flynnr2/Arduino.Nano.Every.TickTock/Docs/CFG_Key_Dictionary.md

# CFG Key Dictionary

Moved to [`Protocol_Wire_Contract.md`](Protocol_Wire_Contract.md), section “CFG records and keys”.

`Protocol_Wire_Contract.md` is the primary documentation home for emitted serial records and CFG keys.
