flynnr2/Arduino.Nano.Every.TickTock/Hardware/OpticalSensorMount/preview-dual.png

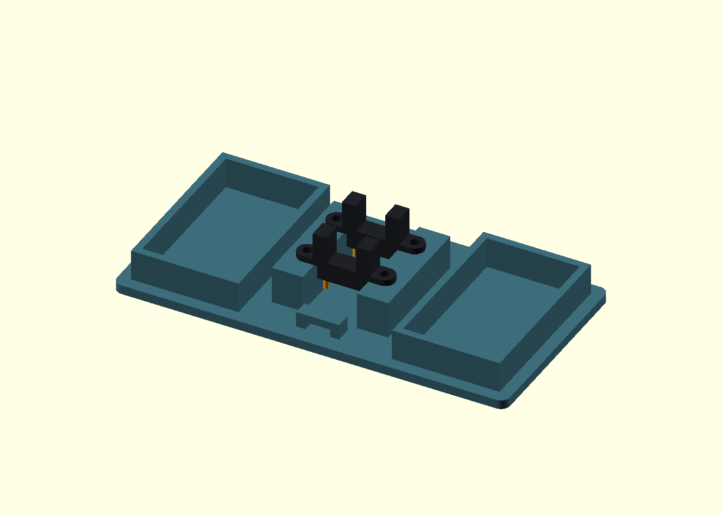
Hardware/OpticalSensorMount/preview-dual.png
