flynnr2/Arduino.Nano.Every.TickTock/Hardware/OpticalSensorMount/opb912_single.stl

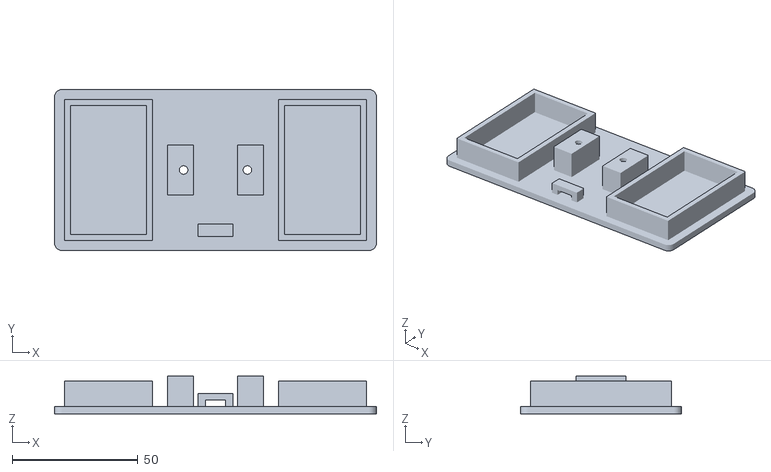
[picture p3: CAD file, 2026-11-06]
Hardware/OpticalSensorMount/opb912_single.stl
128.0 x 64.0 x 15.0
