flynnr2/Arduino.Nano.Every.TickTock/Hardware/OpticalSensorMount/opb912_fit_coupon.stl

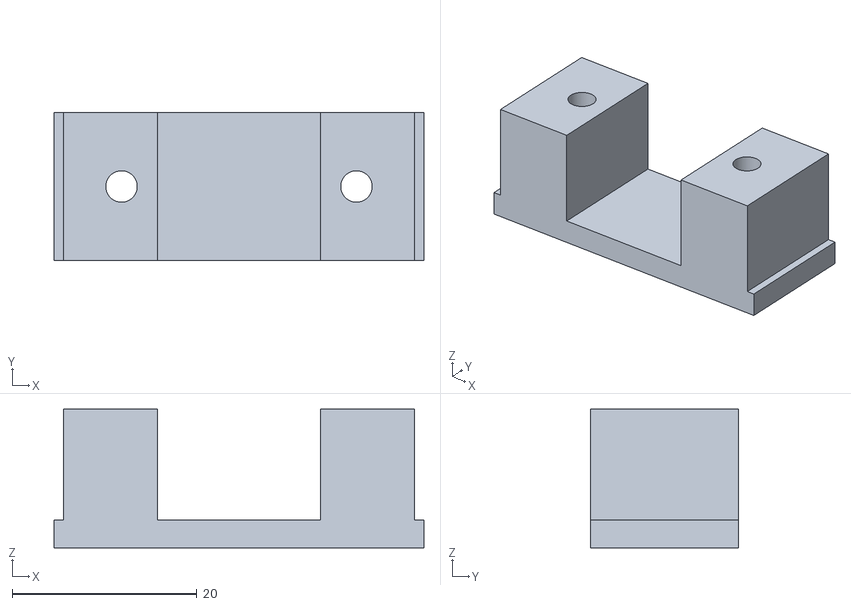
[picture p4: CAD file, 2026-11-06]
Hardware/OpticalSensorMount/opb912_fit_coupon.stl
40.0 x 16.0 x 15.0
