flynnr2/Arduino.Nano.Every.TickTock/tests/golden/phase15_impulse.csv

seq | full_s | full_resid_us | t_s
0 | 2.0 | 10.0 | 0.0
1 | 2.0 | 0.0 | 2.0
2 | 2.0 | 0.0 | 4.0
3 | 2.0 | 0.0 | 6.0
4 | 2.0 | 0.0 | 8.0
5 | 2.0 | 0.0 | 10.0
6 | 2.0 | 0.0 | 12.0
7 | 2.0 | 0.0 | 14.0
8 | 2.0 | 0.0 | 16.0
9 | 2.0 | 0.0 | 18.0
10 | 2.0 | 0.0 | 20.0
11 | 2.0 | 0.0 | 22.0
12 | 2.0 | 0.0 | 24.0
13 | 2.0 | 0.0 | 26.0
14 | 2.0 | 0.0 | 28.0
15 | 2.0 | 10.0 | 30.0
