flynnr2/Arduino.Nano.Every.TickTock/tests/golden/tick_tock_asymmetry.csv

seq | half_A_s | half_B_s | full_s | half_asymmetry_ms | full_resid_us | t_s
0 | 1.001 | 0.999 | 2.0 | 2.0 | 0.0 | 0.0
1 | 1.001 | 0.999 | 2.0 | 2.0 | 0.0 | 2.0
2 | 1.001 | 0.999 | 2.0 | 2.0 | 0.0 | 4.0
