flynnr2/Arduino.Nano.Every.TickTock/tests/raspberry_pi/fixtures/csv-reference/PCPS.CSV

seq | edge_tcb0 | gps_status | holdover_age_ms | cap16 | latency16 | now32 | drop_pps | temperature_C | humidity_pct | pressure_hPa
1 | 416000000 | 1 | 0 | 43008 | 64 | 416000064 | 0 | 20.01 | 50.00 | 1013.25
2 | 432000000 | 1 | 0 | 52224 | 64 | 432000064 | 0 | 20.02 | 50.00 | 1013.25
3 | 448000000 | 1 | 0 | 61440 | 64 | 448000064 | 0 | 20.03 | 50.00 | 1013.25
4 | 464000000 | 1 | 0 | 5120 | 64 | 464000064 | 0 | 20.04 | 50.00 | 1013.25
5 | 480000000 | 1 | 0 | 14336 | 64 | 480000064 | 0 | 20.05 | 50.00 | 1013.25
6 | 496000000 | 1 | 0 | 23552 | 64 | 496000064 | 0 | 20.06 | 50.00 | 1013.25
7 | 512000000 | 1 | 0 | 32768 | 64 | 512000064 | 0 | 20.07 | 50.00 | 1013.25
8 | 528000000 | 1 | 0 | 41984 | 64 | 528000064 | 0 | 20.08 | 50.00 | 1013.25
9 | 544000000 | 1 | 0 | 51200 | 64 | 544000064 | 0 | 20.09 | 50.00 | 1013.25
10 | 560000000 | 1 | 0 | 60416 | 64 | 560000064 | 0 | 20.10 | 50.00 | 1013.25
11 | 576000000 | 1 | 0 | 4096 | 64 | 576000064 | 0 | 20.11 | 50.00 | 1013.25
12 | 592000000 | 1 | 0 | 13312 | 64 | 592000064 | 0 | 20.12 | 50.00 | 1013.25
13 | 608000000 | 1 | 0 | 22528 | 64 | 608000064 | 0 | 20.13 | 50.00 | 1013.25
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
