flynnr2/Arduino.Nano.Every.TickTock/tests/raspberry_pi/fixtures/csv-reference/PCSW.CSV

seq | edge0_tcb0 | edge1_tcb0 | edge2_tcb0 | edge3_tcb0 | edge4_tcb0 | drop_ir | drop_pps | drop_swing | adj_diag | adj_comp_diag | temperature_C | humidity_pct | pressure_hPa
1 | 432000000 | 447600000 | 448000000 | 463600000 | 464000000 | 0 | 0 | 0 | 48 | 1755 | 20.01 | 50.00 | 1013.25
2 | 464000000 | 479600000 | 480000000 | 495600000 | 496000000 | 0 | 0 | 0 | 48 | 1755 | 20.02 | 50.00 | 1013.25
3 | 496000000 | 511600000 | 512000000 | 527600000 | 528000000 | 0 | 0 | 0 | 48 | 1755 | 20.03 | 50.00 | 1013.25
4 | 528000000 | 543600000 | 544000000 | 559600000 | 560000000 | 0 | 0 | 0 | 48 | 1755 | 20.04 | 50.00 | 1013.25
5 | 560000000 | 575600000 | 576000000 | 591600000 | 592000000 | 0 | 0 | 0 | 48 | 1755 | 20.05 | 50.00 | 1013.25
6 | 592000000 | 607600000 | 608000000 | 623600000 | 624000000 | 0 | 0 | 0 | 48 | 1755 | 20.06 | 50.00 | 1013.25
7 | 624000000 | 639600000 | 640000000 | 655600000 | 656000000 | 0 | 0 | 0 | 48 | 1755 | 20.07 | 50.00 | 1013.25
8 | 656000000 | 671600000 | 672000000 | 687600000 | 688000000 | 0 | 0 | 0 | 48 | 1755 | 20.08 | 50.00 | 1013.25
9 | 688000000 | 703600000 | 704000000 | 719600000 | 720000000 | 0 | 0 | 0 | 48 | 1755 | 20.09 | 50.00 | 1013.25
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
