flynnr2/Arduino.Nano.Every.TickTock/Hardware/NanoEveryCarrierA9/output/pdf/NanoEveryCarrier-Schematic-A9-Wired.pdf

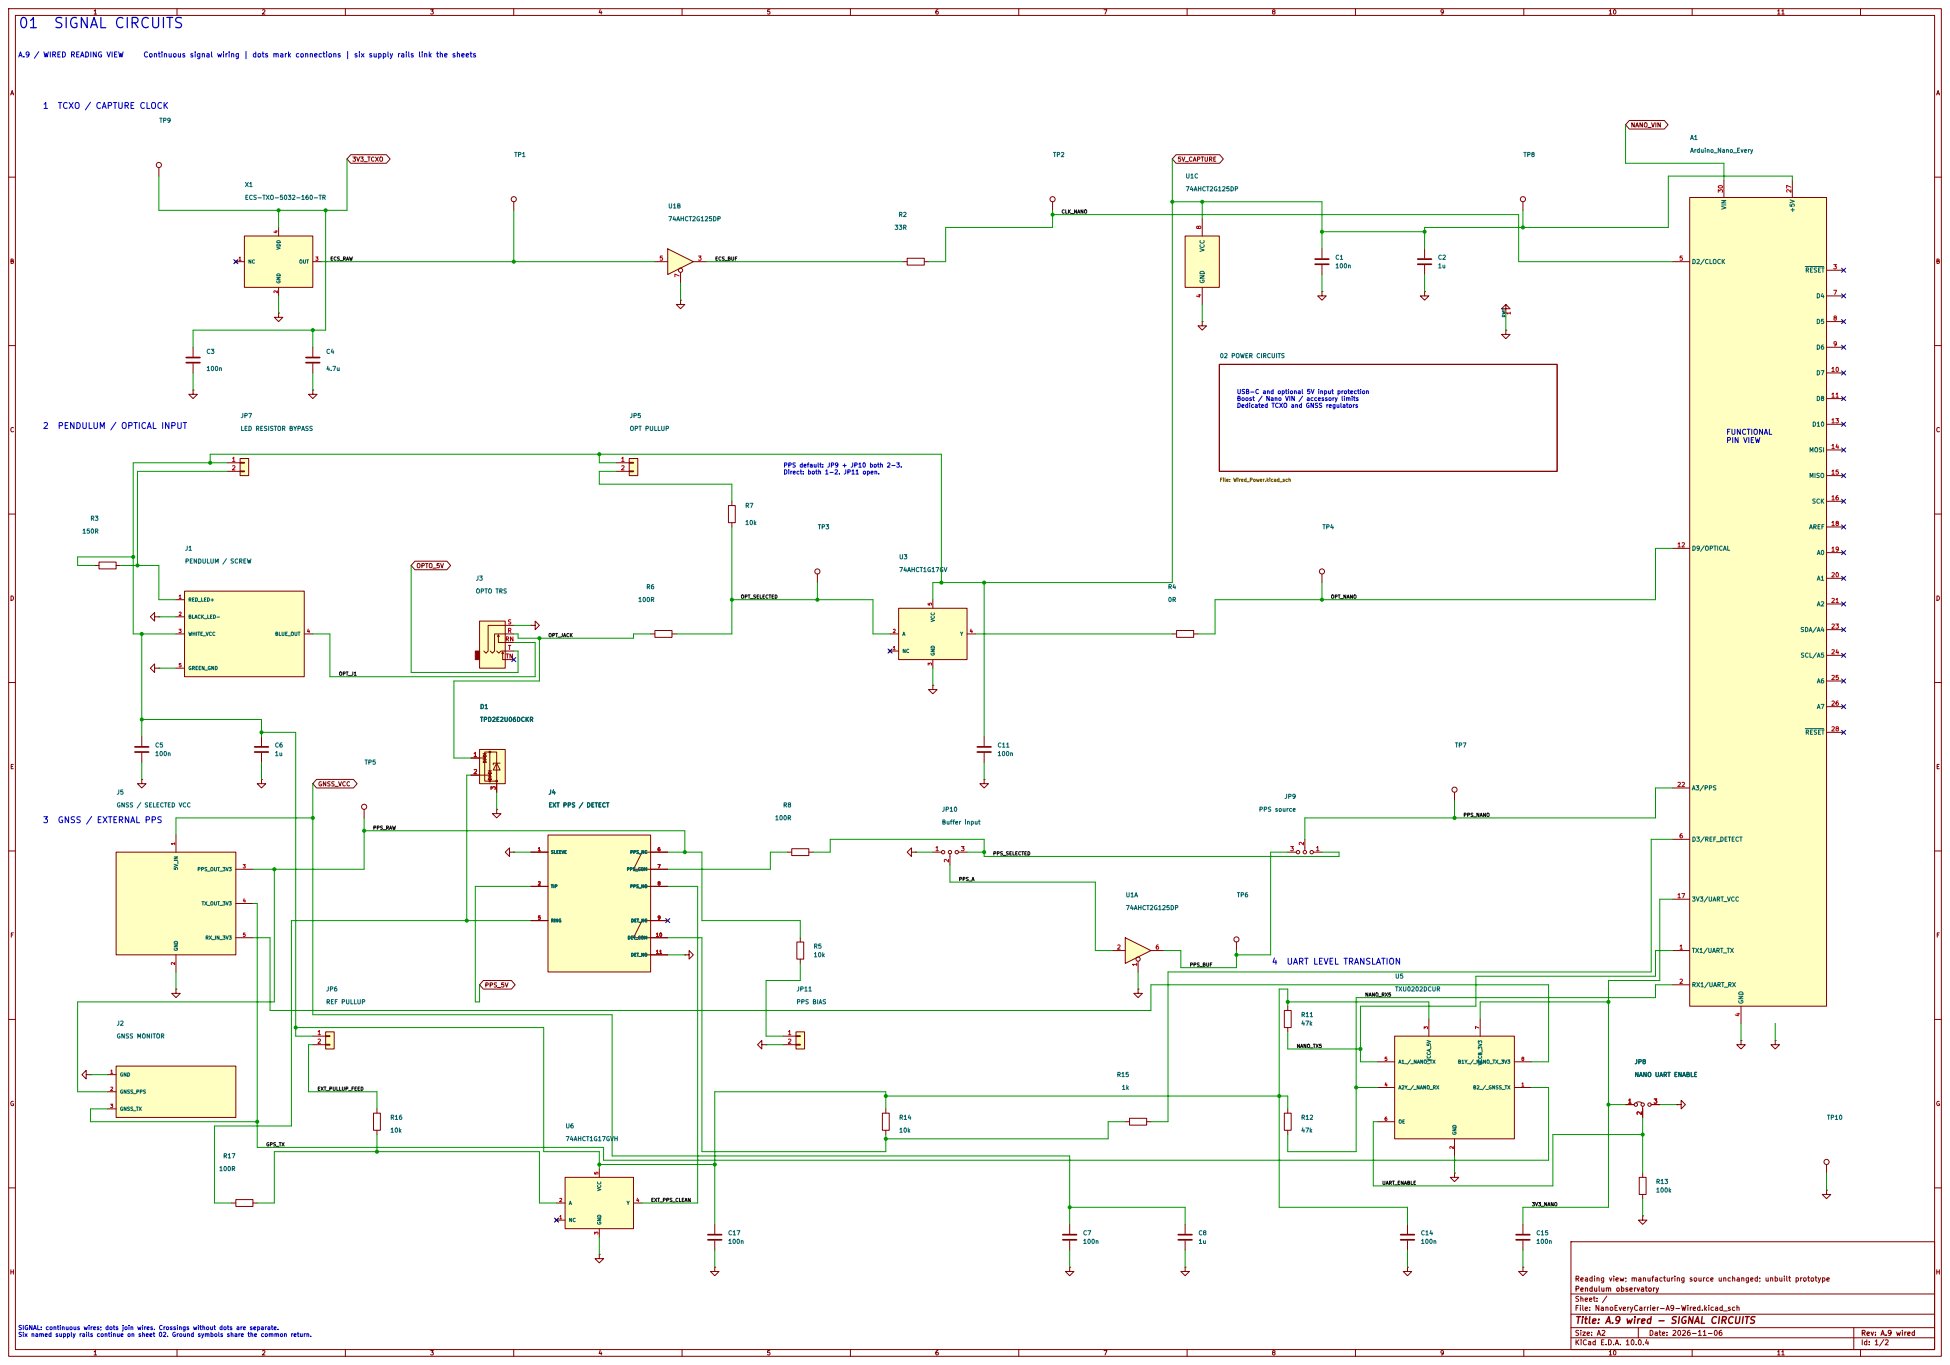
[picture p11: page 1]

USB-C and optional 5V input protection Boost / Nano VIN / accessory limits Dedicated TCXO and GNSS regulators

PPS default: JP9 + JP10 both 2-3. Direct: both 1-2. JP11 open.

Reading view; manufacturing source unchanged; unbuilt prototype
Pendulum observatory
Sheet: /
File: NanoEveryCarrier-A9-Wired.kicad_sch
Title: A.9 wired - SIGNAL CIRCUITS

SIGNAL: continuous wires; dots join wires. Crossings without dots are separate. Six named supply rails continue on sheet 02. Ground symbols share the common return.

Size: A2 | Rev: A.9 wired
KiCad E.D.A. 10.0.4 | Id: 1/2

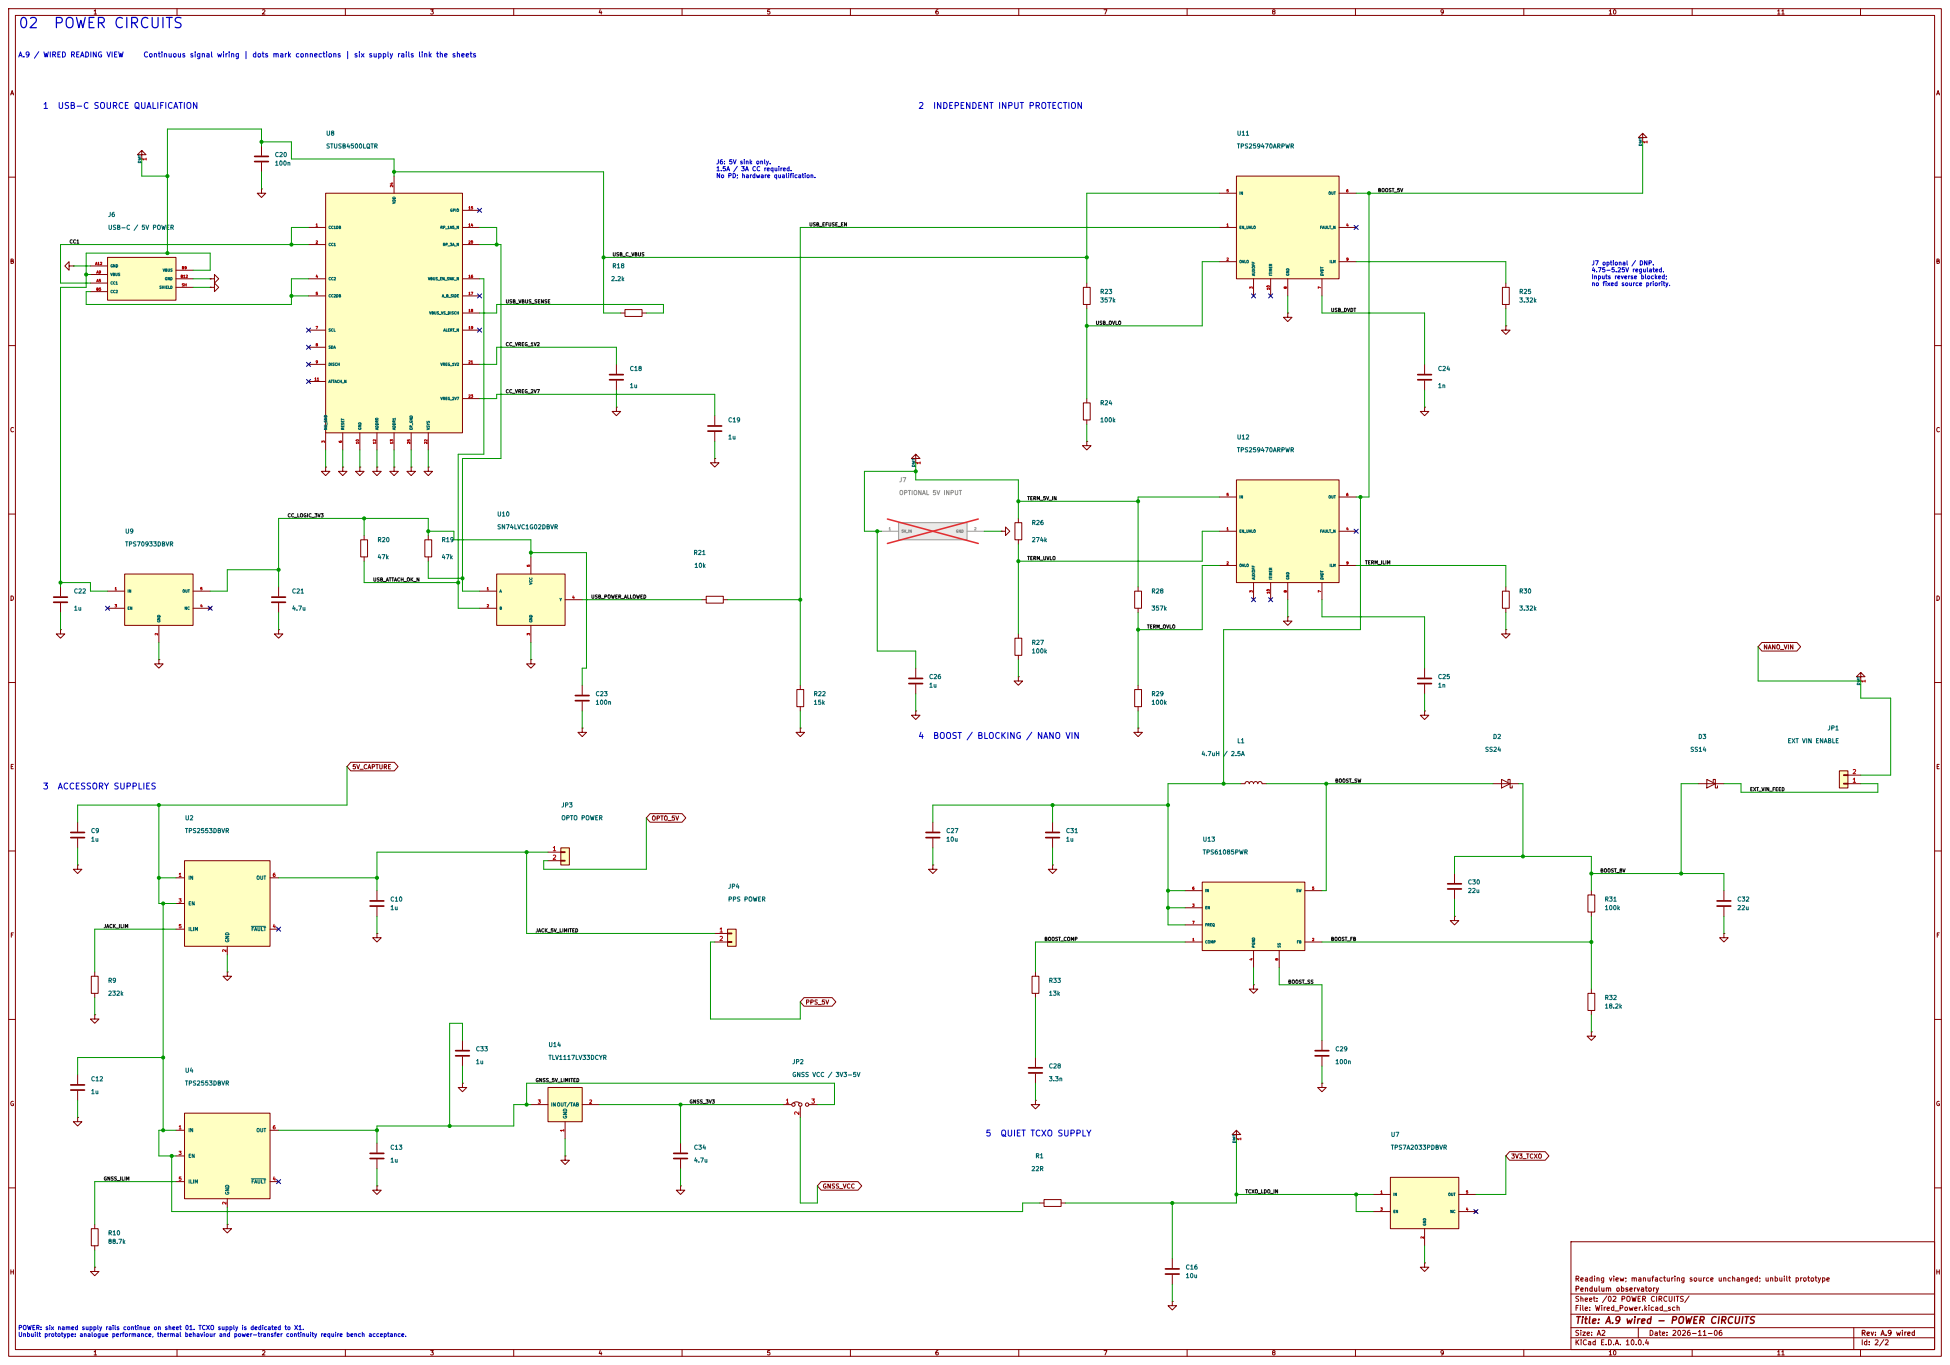
[picture p12: page 2]

J6: 5V sink only. 1.5A / 3A CC required. No PD; hardware qualification.

Inputs reverse blocked; no fixed source priority.

4 BOOST / BLOCKING / NANO VIN

Reading view; manufacturing source unchanged; unbuilt prototype
Pendulum observatory
Sheet: /02 POWER CIRCUITS/
File: Wired_Power.kicad_sch
Title: A.9 wired - POWER CIRCUITS

POWER: six named supply rails continue on sheet 01. TCXO supply is dedicated to X1. Unbuilt prototype: analogue performance, thermal behaviour and power-transfer continuity require bench acceptance.

Size: A2 | Rev: A.9 wired
KiCad E.D.A. 10.0.4 | Id: 2/2
