flynnr2/Arduino.Nano.Every.TickTock/Hardware/NanoEveryCarrierA9/NanoEveryCarrier.kicad_pcb

## KiCad design Hardware/NanoEveryCarrierA9/NanoEveryCarrier.kicad_pcb (2026-11-06)

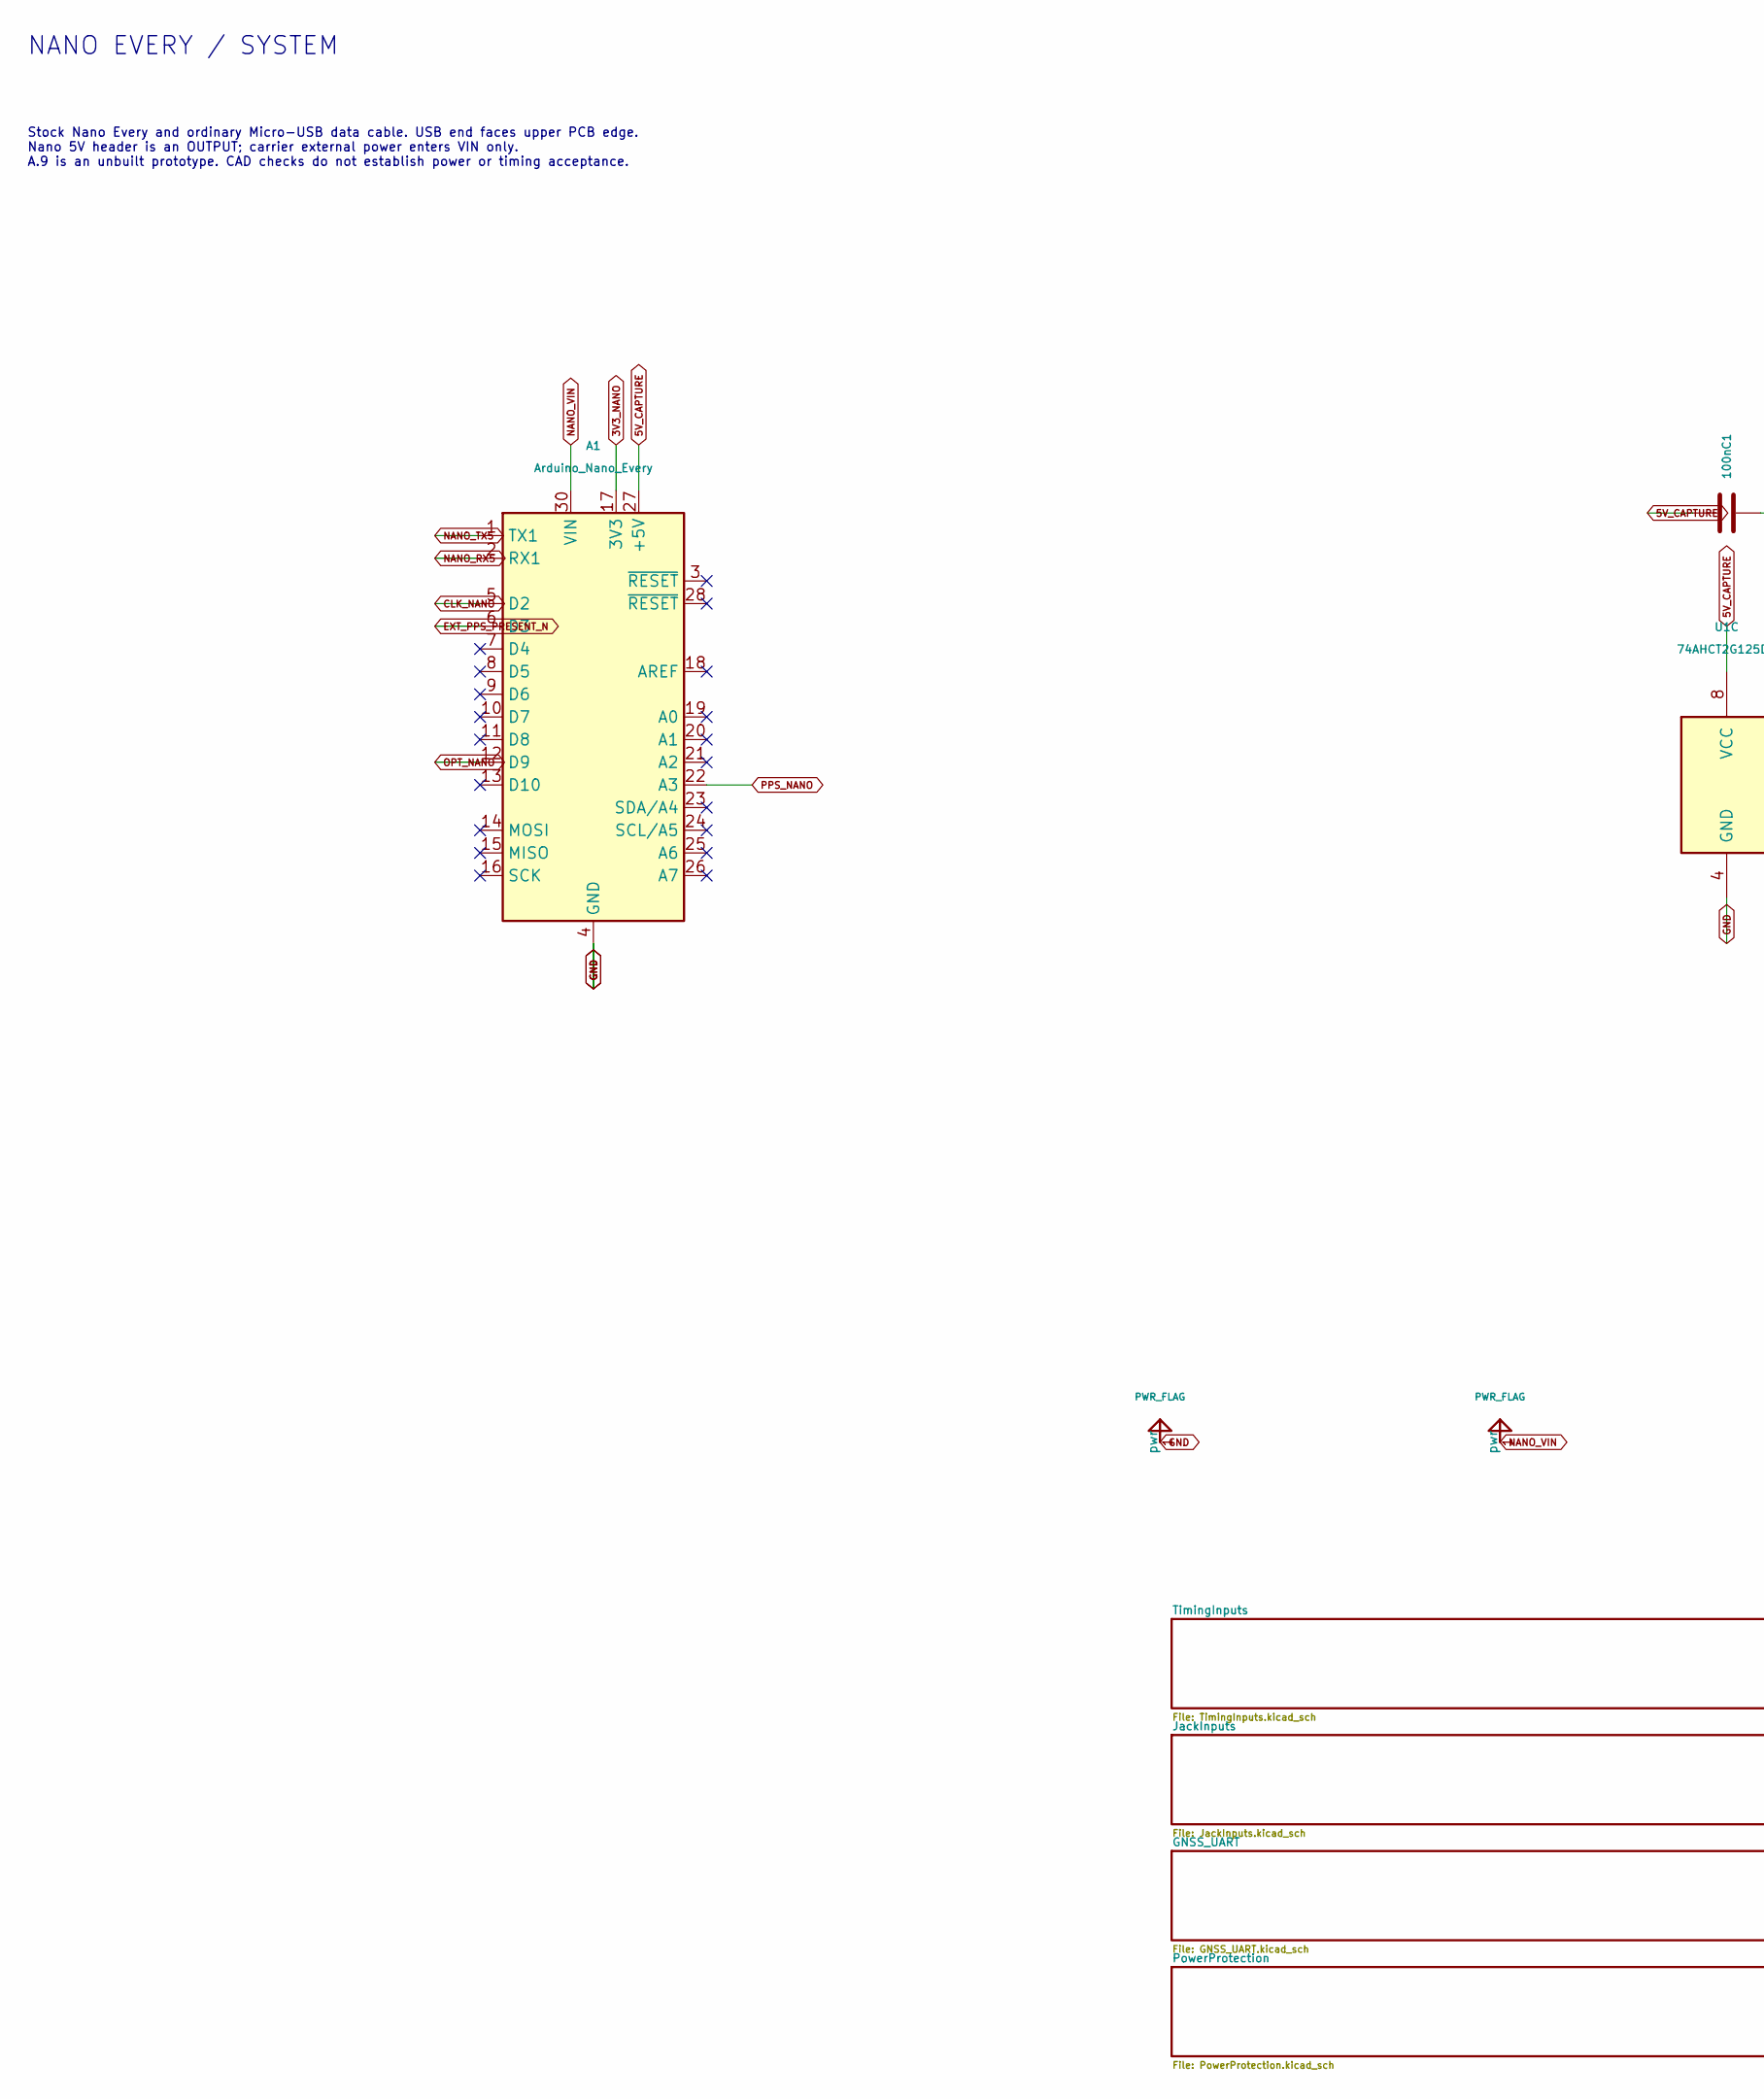
[picture p22: schematic NanoEveryCarrier.kicad_sch, A.9 | NANO EVERY / SYSTEM, part in row 1, column 1]

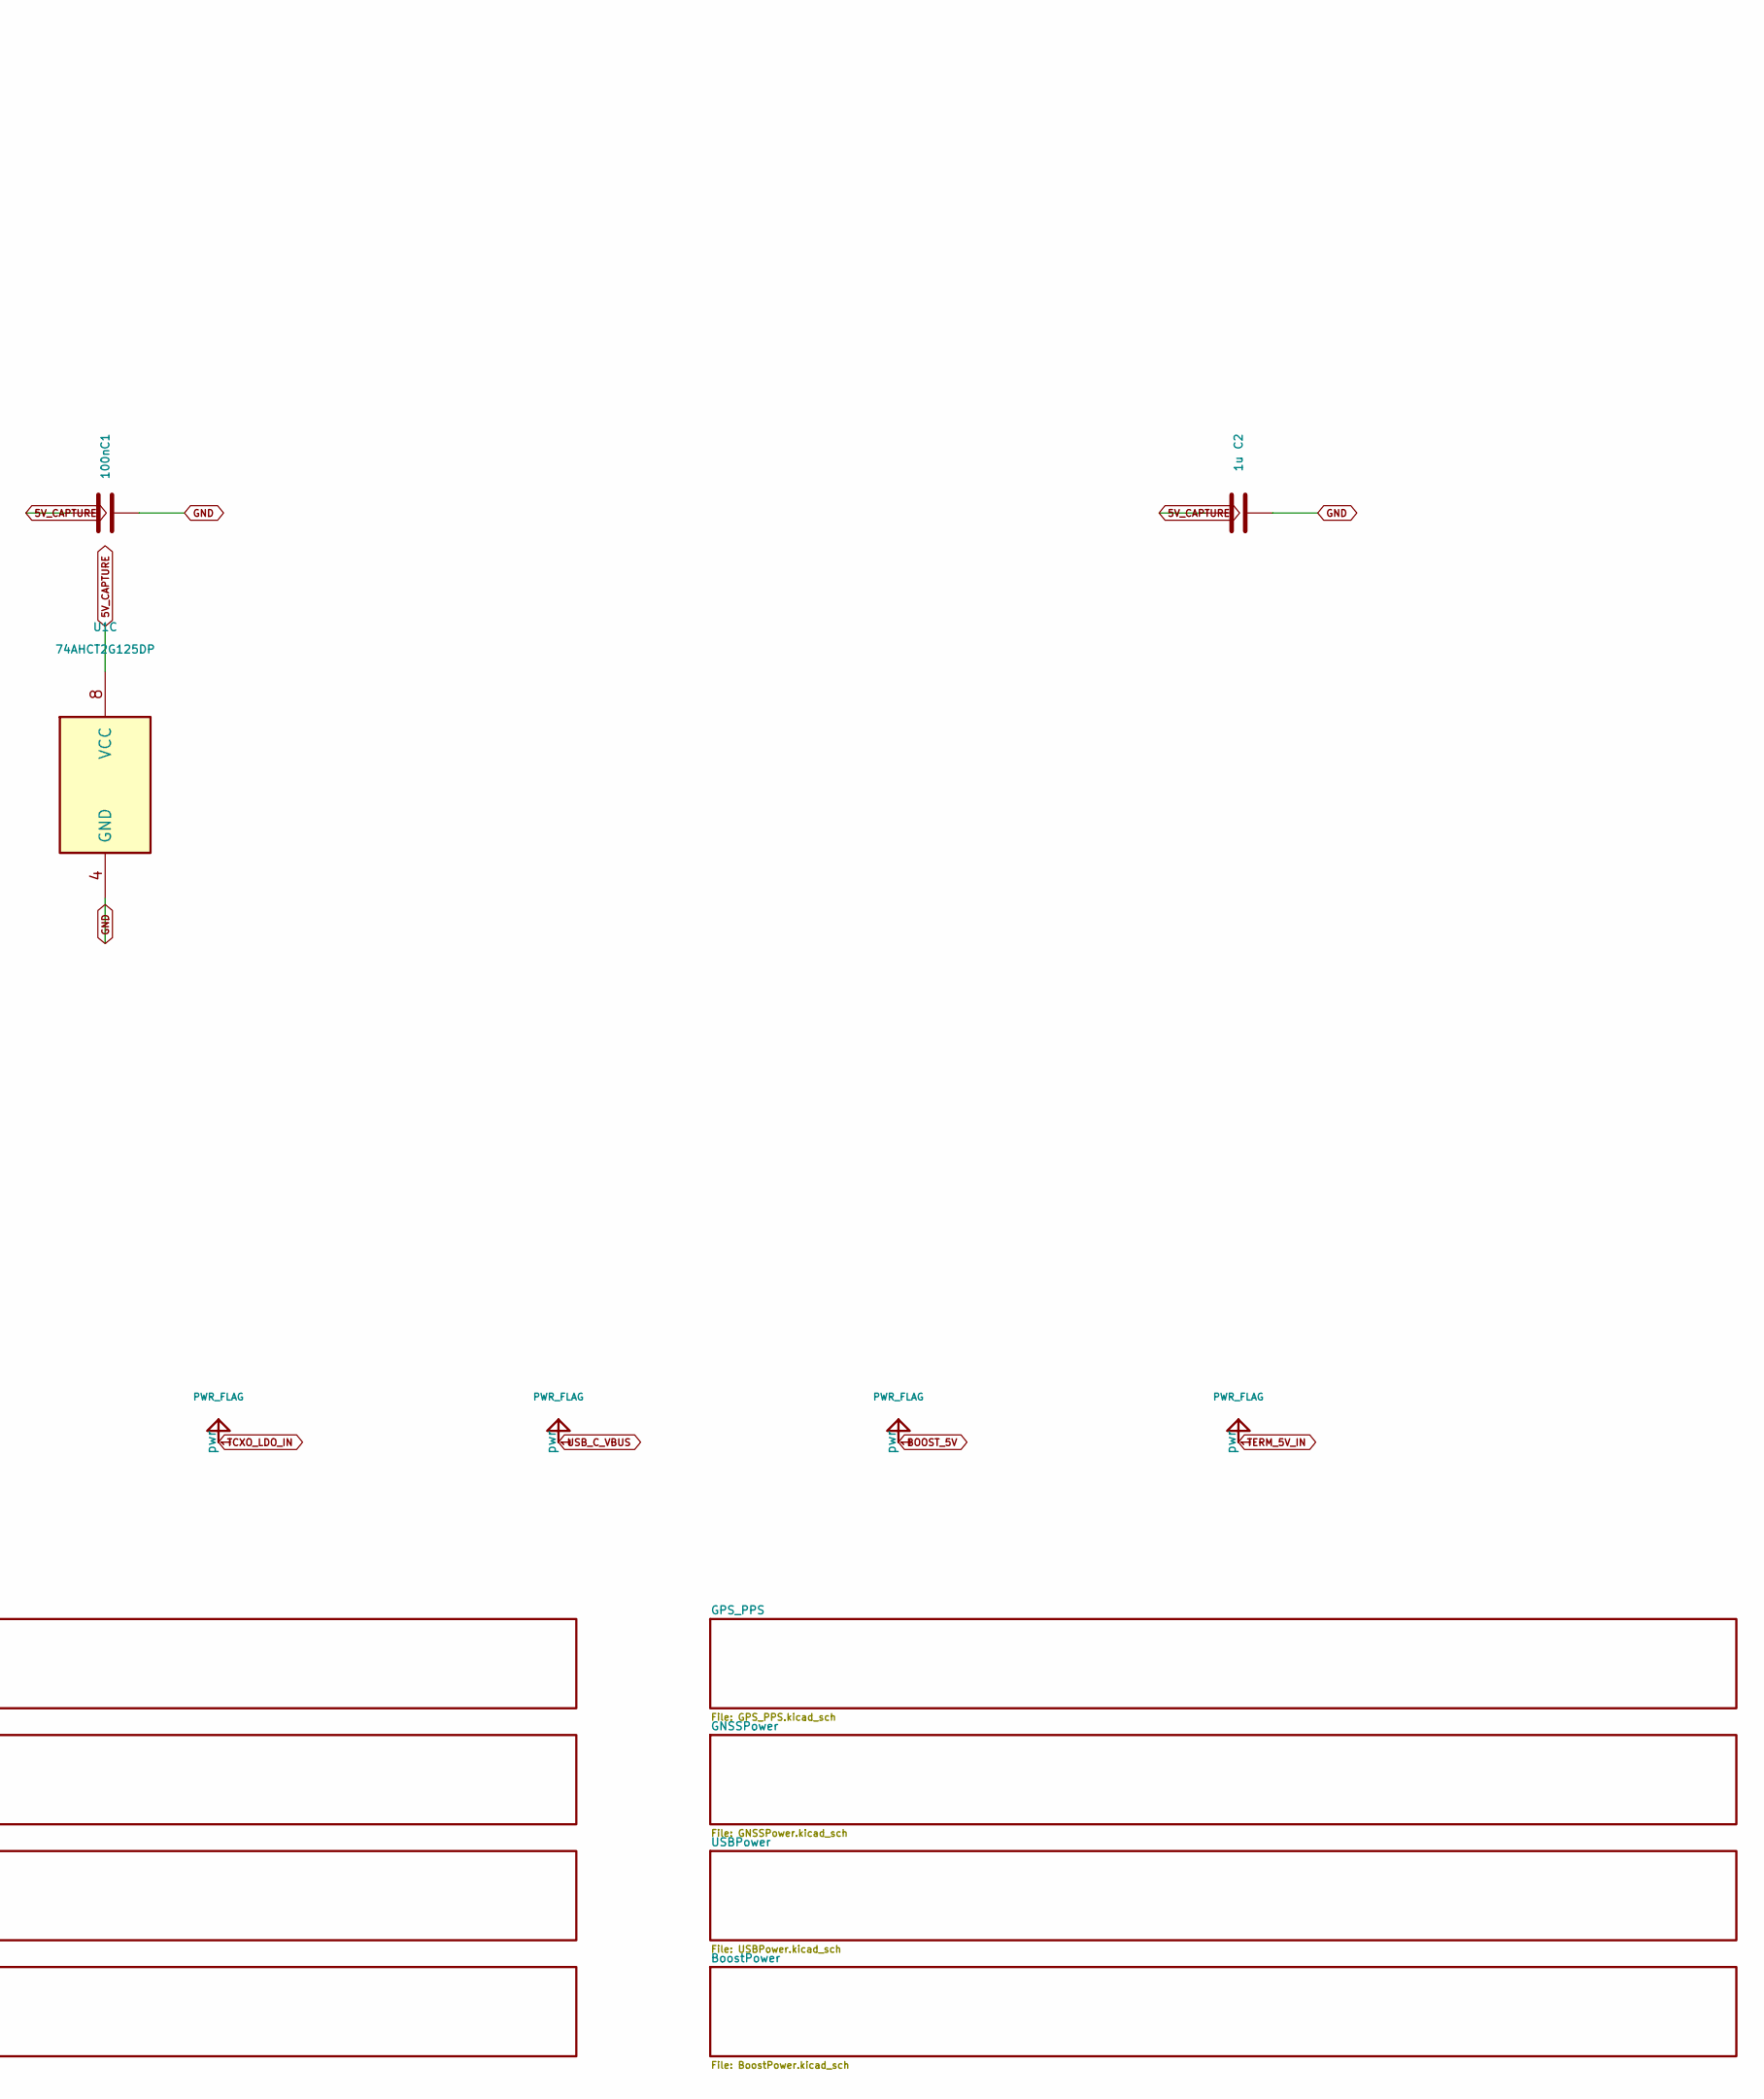
[picture p23: schematic NanoEveryCarrier.kicad_sch, A.9 | NANO EVERY / SYSTEM, part in row 1, column 2]

Parts:
A1: Arduino_Nano_Every; Nano_Every_Sockets; MPN SSW-115-01-G-S
C1: 100n; C_0805_2012Metric; MPN GRM21BR71H104KA01L
C2: 1u; C_0805_2012Metric; MPN GRM21BR71C105KA01L
U1: 74AHCT2G125DP; TSSOP-8_3x3mm_P0.65mm; MPN 74AHCT2G125DP,125

Connections:
3V3_NANO: A1.17 (3V3); also elsewhere on the board
5V_CAPTURE: A1.27 (+5V), C1.1, C2.1, U1.8 (VCC); also elsewhere on the board
CLK_NANO: A1.5 (D2); also elsewhere on the board
EXT_PPS_PRESENT_N: A1.6 (D3); also elsewhere on the board
GND: A1.4 (GND), A1.29 (GND), C1.2, C2.2, U1.4 (GND); also elsewhere on the board
NANO_RX5: A1.2 (RX1); also elsewhere on the board
NANO_TX5: A1.1 (TX1); also elsewhere on the board
NANO_VIN: A1.30 (VIN); also elsewhere on the board
OPT_NANO: A1.12 (D9); also elsewhere on the board
PPS_NANO: A1.22 (A3); also elsewhere on the board

Notes on the sheet:
NANO EVERY / SYSTEM
Stock Nano Every and ordinary Micro-USB data cable. USB end faces upper PCB edge. Nano 5V header is an OUTPUT; carrier external power enters VIN only. A.9 is an unbuilt prototype. CAD checks do not establish power or timing acceptance.

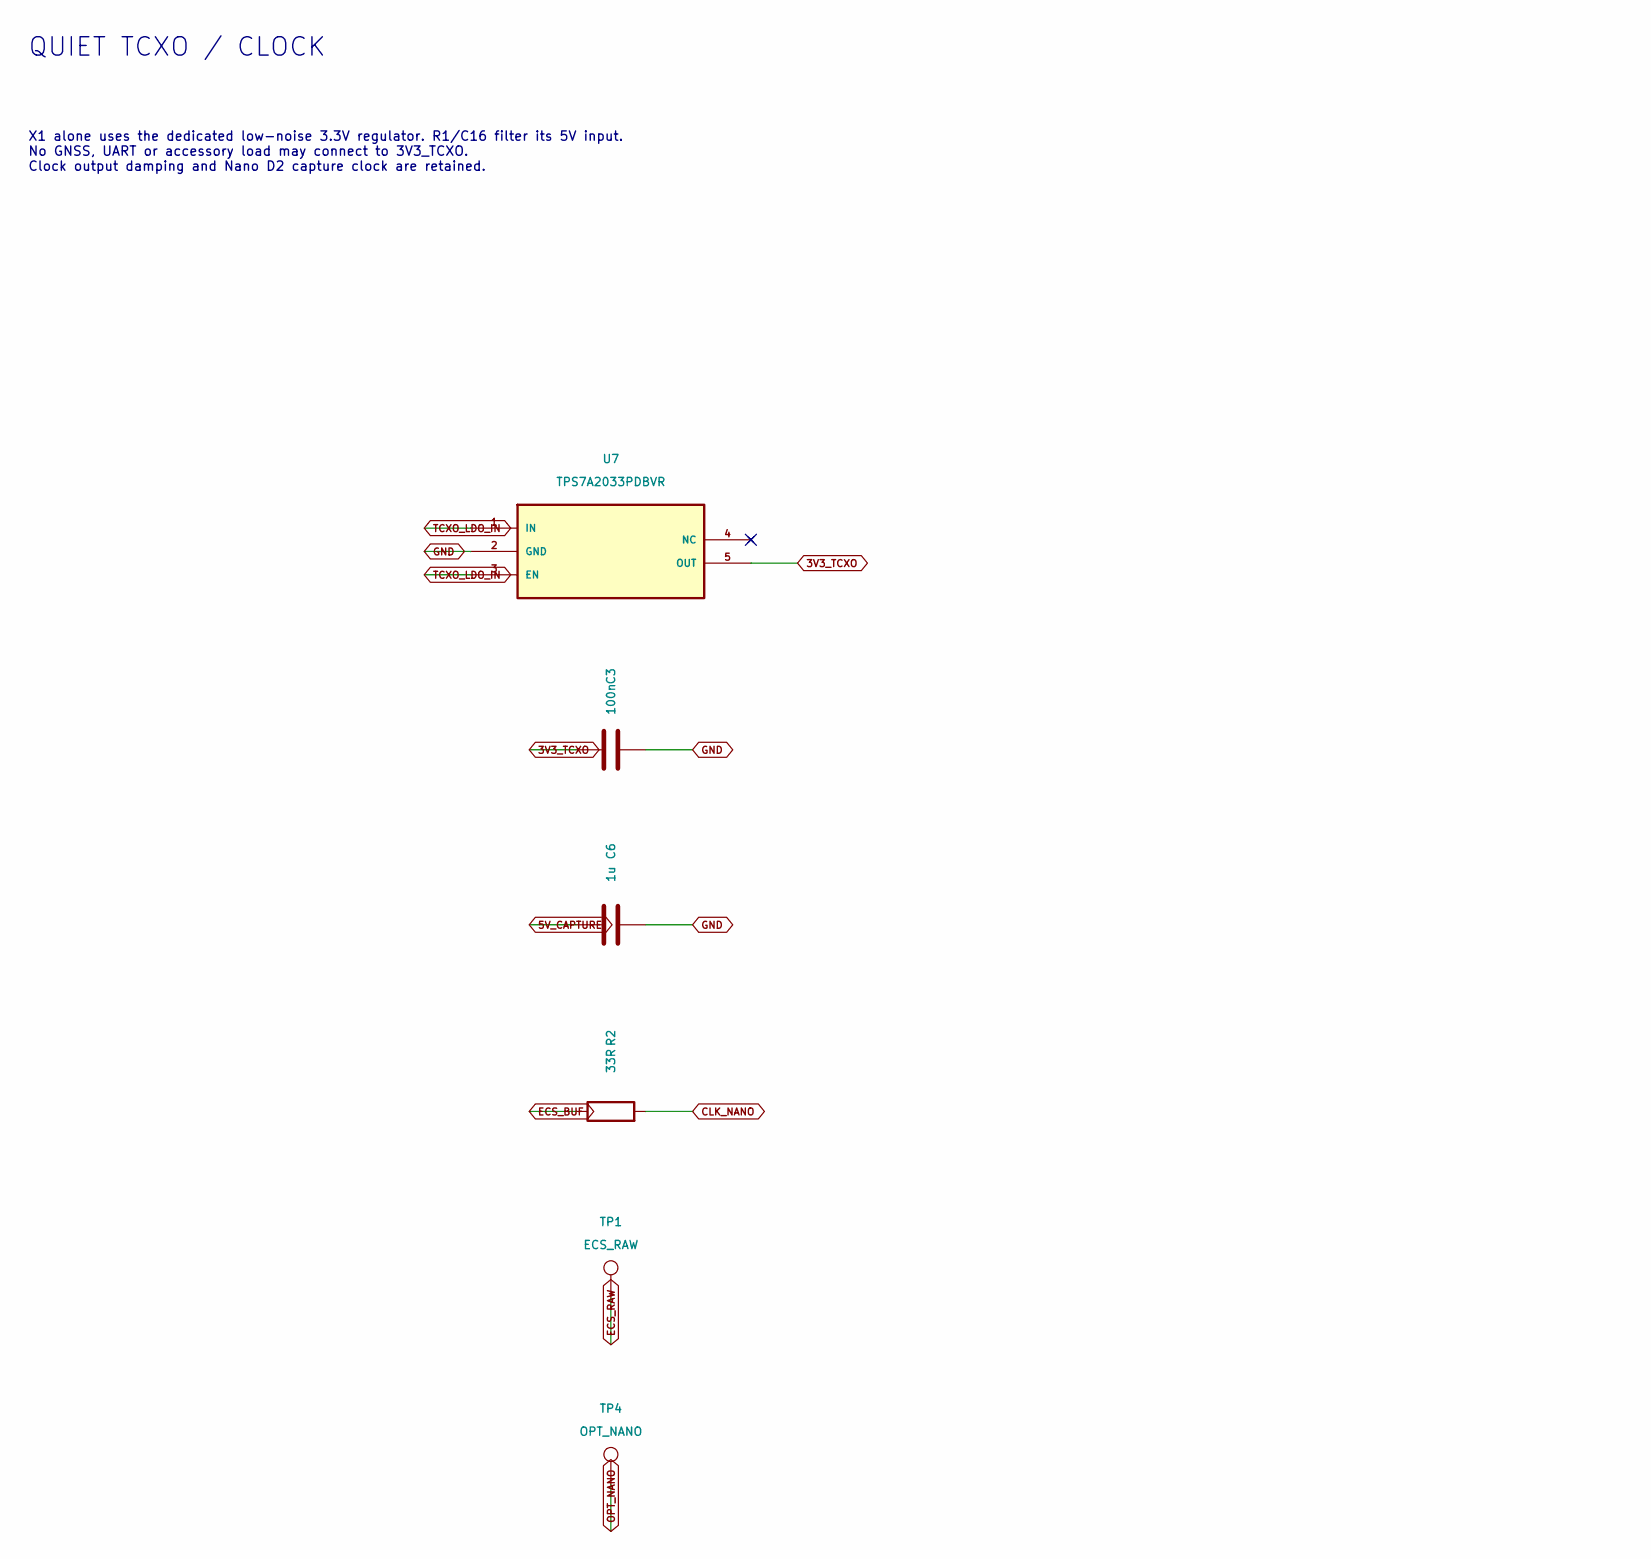
[picture p24: schematic TimingInputs.kicad_sch, A.9 | QUIET TCXO / CLOCK, part in row 1, column 1]

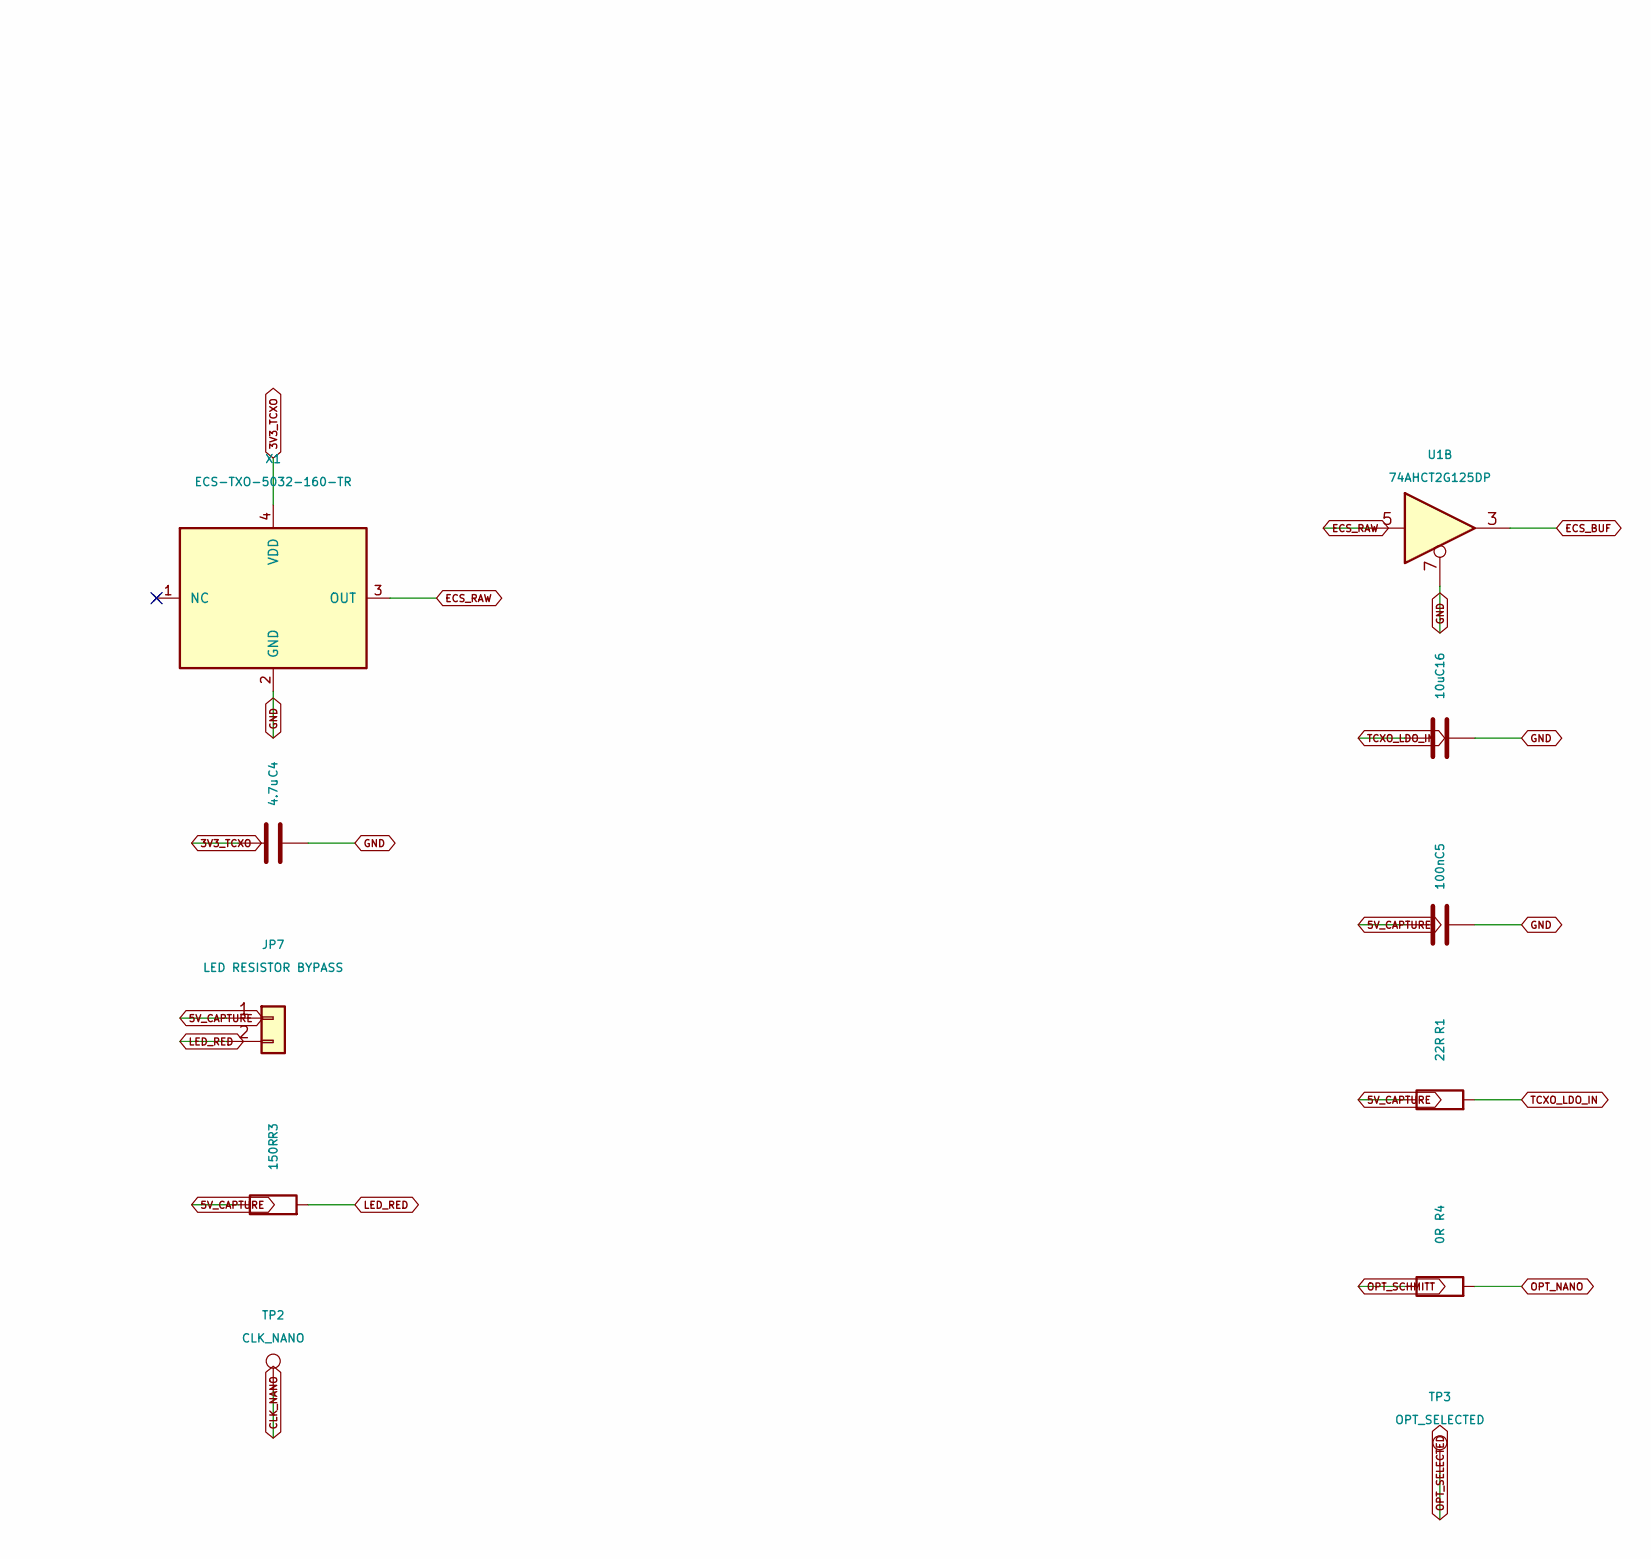
[picture p25: schematic TimingInputs.kicad_sch, A.9 | QUIET TCXO / CLOCK, part in row 1, column 2]

Parts:
C3, C5: 100n; C_0805_2012Metric; MPN GRM21BR71H104KA01L
C4: 4.7u; C_0805_2012Metric; MPN GRM21BR71C475KA73L
C6: 1u; C_0805_2012Metric; MPN GRM21BR71C105KA01L
C16: 10u; C_0805_2012Metric; MPN GRM21BR61C106KE15L
JP7: LED RESISTOR BYPASS; PinHeader_1x02_P2.54mm_Vertical; MPN TSW-102-07-G-S
R1: 22R; R_0805_2012Metric; MPN RC0805FR-0722RL
R2: 33R; R_1206_3216Metric_Pad1.30x1.75mm_HandSolder; MPN RC1206FR-0733RL
R3: 150R; R_1206_3216Metric; MPN RC1206FR-07150RL
R4: 0R; R_1206_3216Metric_Pad1.30x1.75mm_HandSolder; MPN RC1206JR-070RL
TP1: ECS_RAW; TestPoint_Pad_D1.0mm
TP2: CLK_NANO; TestPoint_Pad_D1.0mm
TP3: OPT_SELECTED; TestPoint_Pad_D1.0mm
TP4: OPT_NANO; TestPoint_Pad_D1.0mm
U1: 74AHCT2G125DP; TSSOP-8_3x3mm_P0.65mm; MPN 74AHCT2G125DP,125
U7: TPS7A2033PDBVR; SOT-23-5; MPN TPS7A2033PDBVR
X1: ECS-TXO-5032-160-TR; ECS_TXO_5032; MPN ECS-TXO-5032-160-TR

Connections:
3V3_TCXO: C3.1, C4.1, U7.5 (OUT), X1.4 (VDD); also elsewhere on the board
5V_CAPTURE: C5.1, C6.1, JP7.1, R1.1, R3.1; also elsewhere on the board
CLK_NANO: R2.2, TP2.1; also elsewhere on the board
ECS_BUF: R2.1, U1.3
ECS_RAW: TP1.1, U1.5, X1.3 (OUT)
GND: C3.2, C4.2, C5.2, C6.2, C16.2, U1.7, U7.2 (GND), X1.2 (GND); also elsewhere on the board
LED_RED: JP7.2, R3.2; also elsewhere on the board
OPT_NANO: R4.2, TP4.1; also elsewhere on the board
OPT_SCHMITT: R4.1; also elsewhere on the board
OPT_SELECTED: TP3.1; also elsewhere on the board
TCXO_LDO_IN: C16.1, R1.2, U7.1 (IN), U7.3 (EN)

Notes on the sheet:
QUIET TCXO / CLOCK
X1 alone uses the dedicated low-noise 3.3V regulator. R1/C16 filter its 5V input. No GNSS, UART or accessory load may connect to 3V3_TCXO. Clock output damping and Nano D2 capture clock are retained.

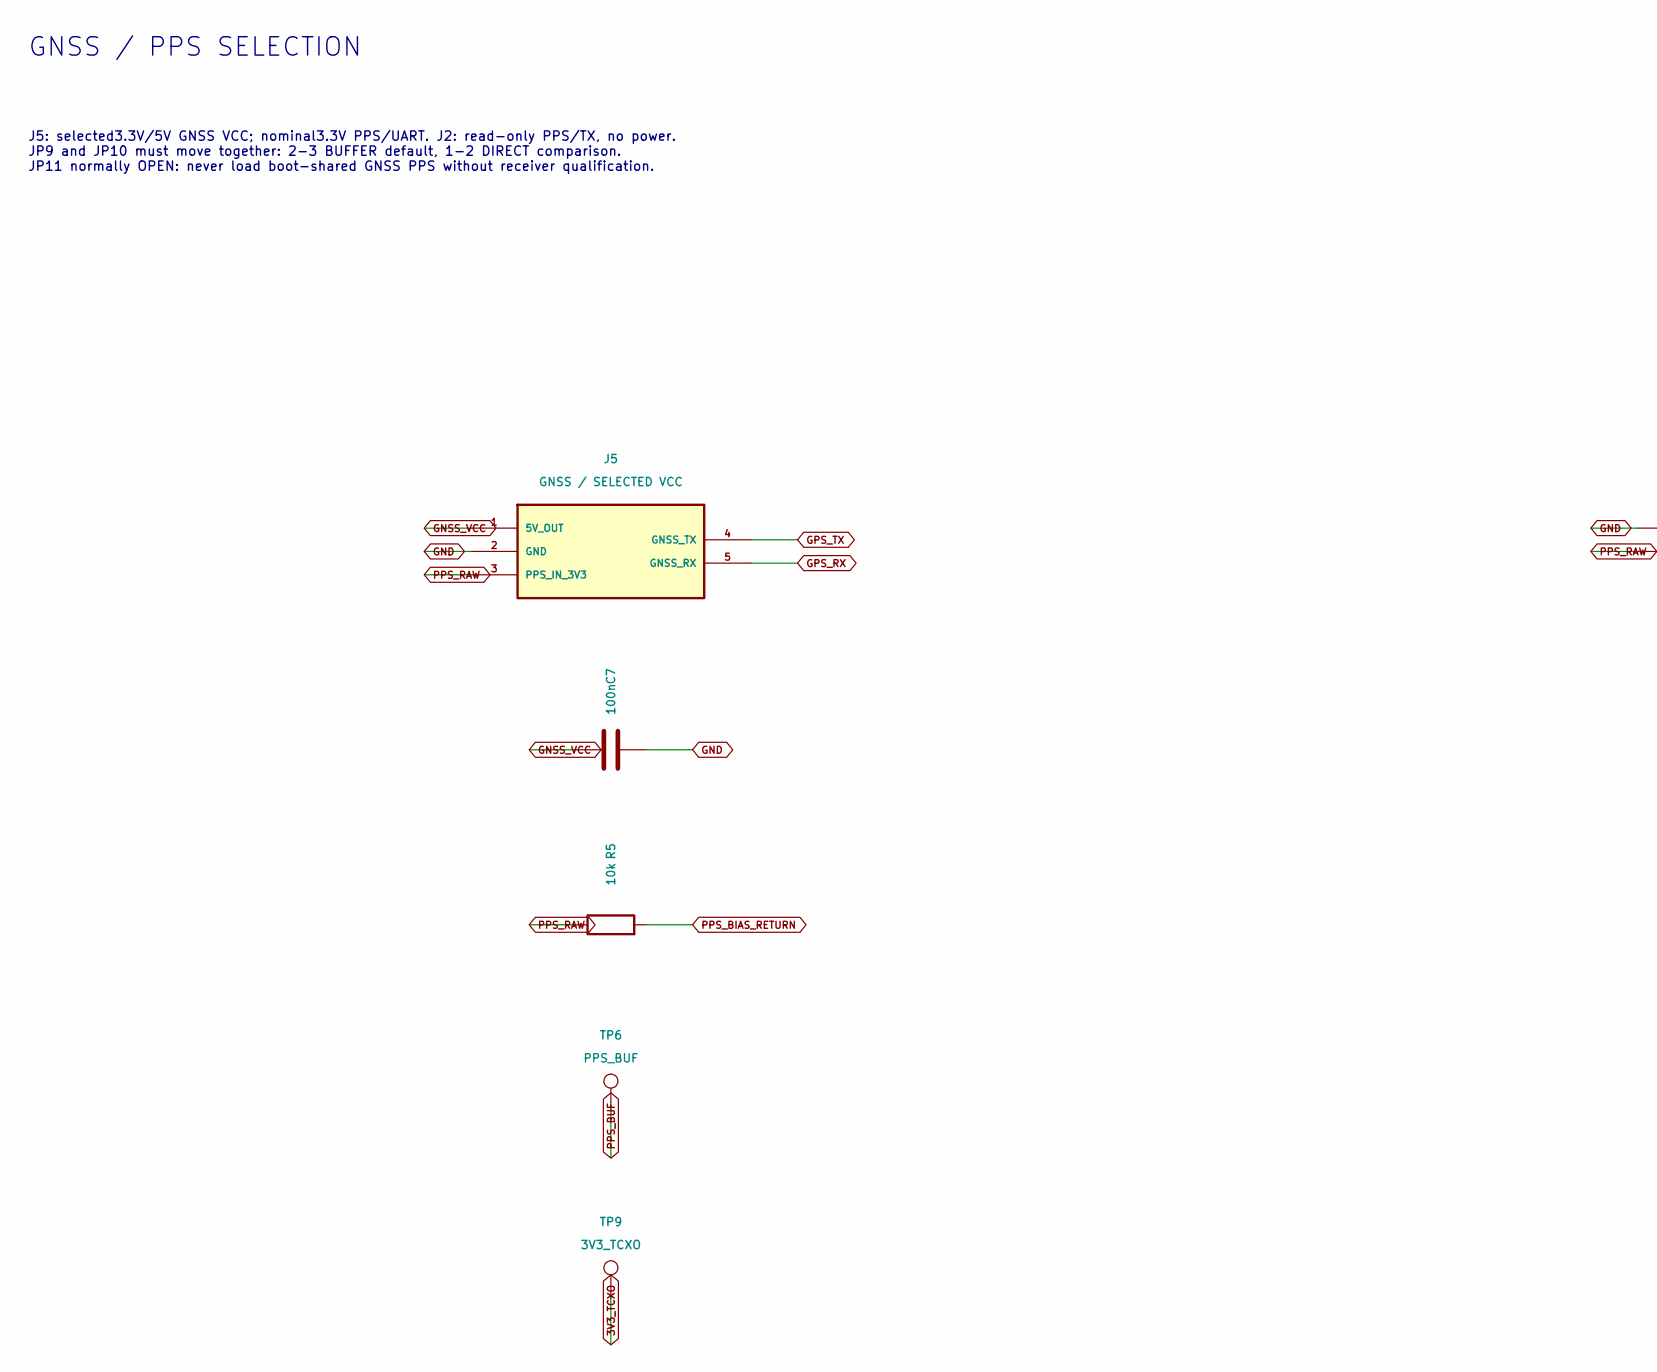
[picture p26: schematic GPS_PPS.kicad_sch, A.9 | GNSS / PPS SELECTION, part in row 1, column 1]

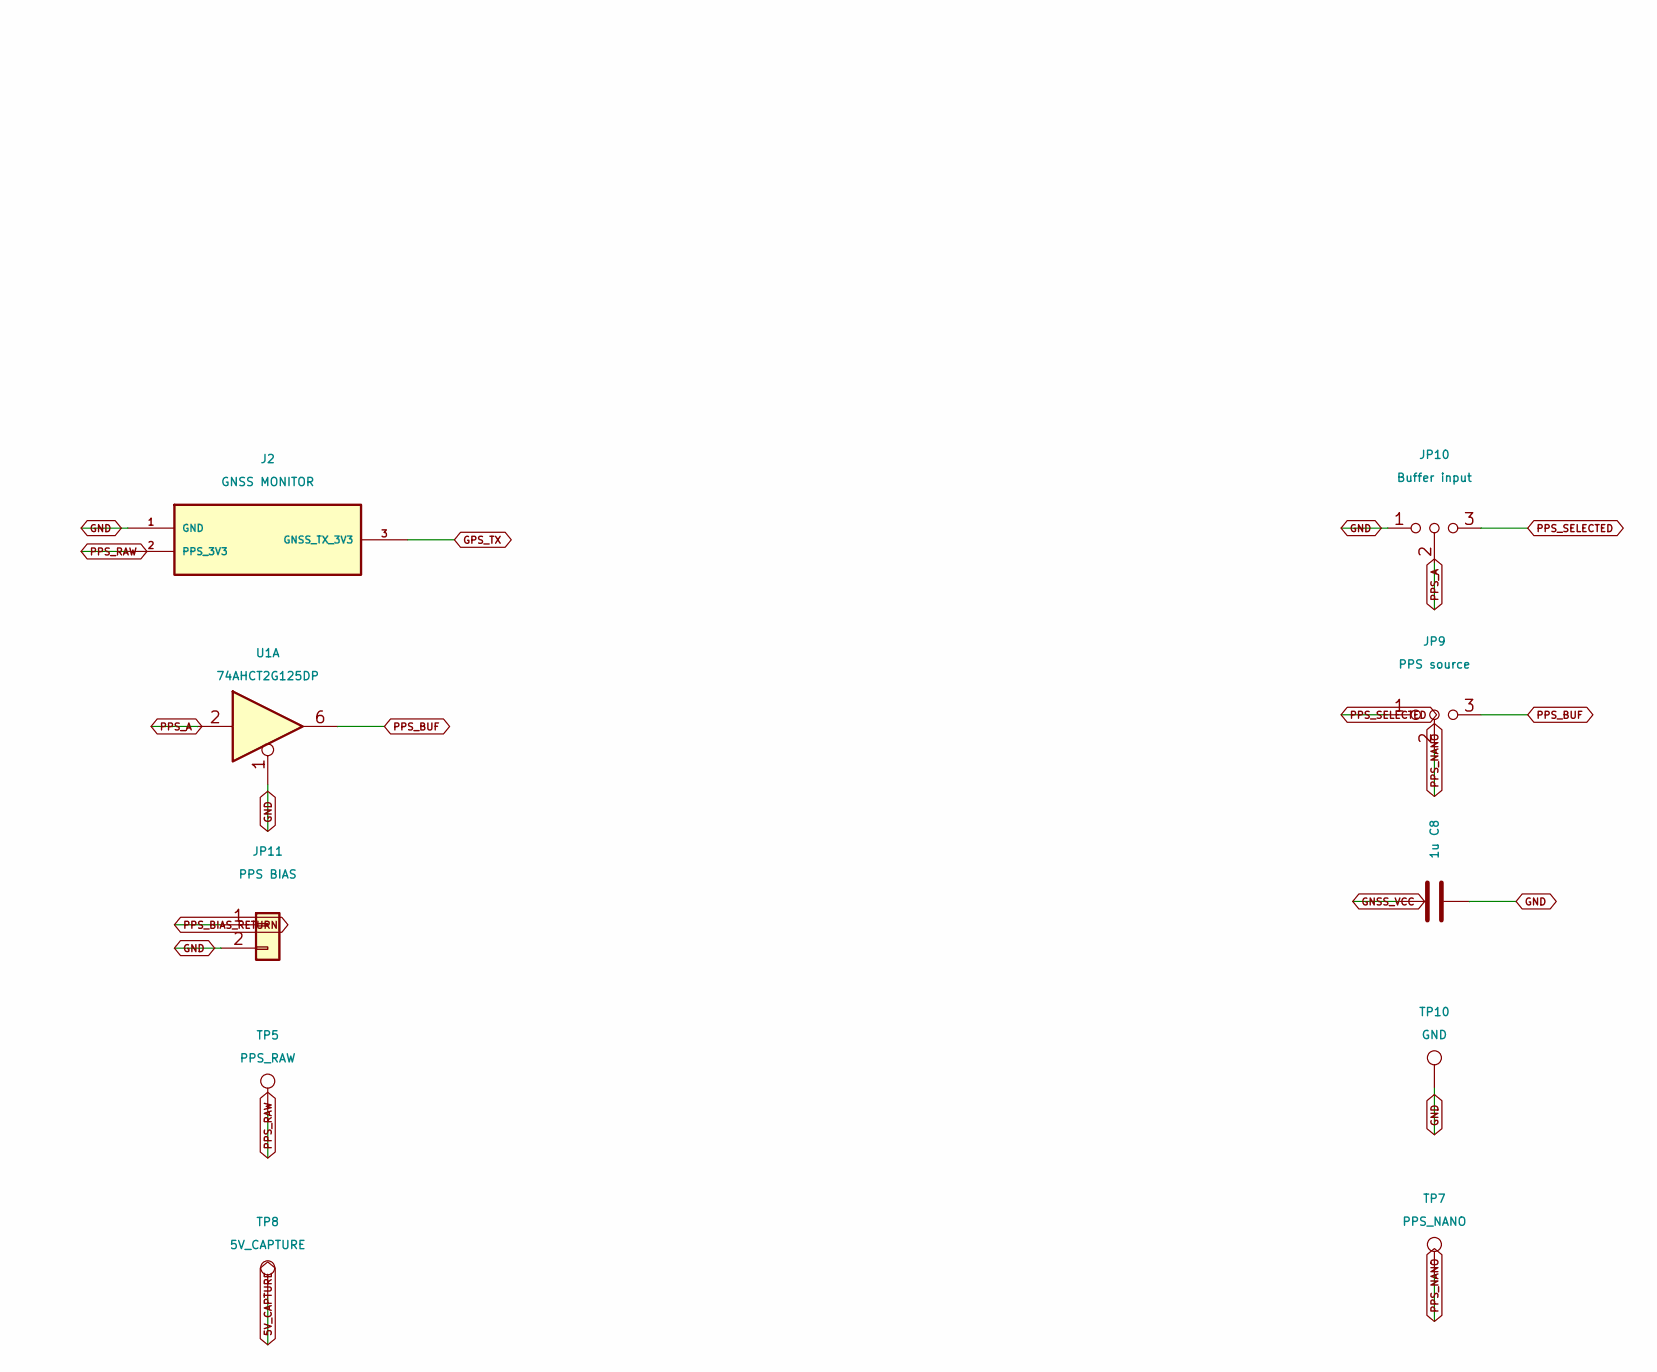
[picture p27: schematic GPS_PPS.kicad_sch, A.9 | GNSS / PPS SELECTION, part in row 1, column 2]

Parts:
C7: 100n; C_0805_2012Metric; MPN GRM21BR71H104KA01L
C8: 1u; C_0805_2012Metric; MPN GRM21BR71C105KA01L
J2: GNSS MONITOR; PinHeader_1x03_P2.54mm_Vertical; MPN TSW-103-07-G-S
J5: GNSS / SELECTED VCC; PinHeader_1x05_P2.54mm_Vertical; MPN TSW-105-07-G-S
JP9: PPS source; PinHeader_1x03_P2.54mm_Vertical; MPN TSW-103-07-G-S
JP10: Buffer input; PinHeader_1x03_P2.54mm_Vertical; MPN TSW-103-07-G-S
JP11: PPS BIAS; PinHeader_1x02_P2.54mm_Vertical; MPN TSW-102-07-G-S
R5: 10k; R_0805_2012Metric; MPN RC0805FR-0710KL
TP5: PPS_RAW; TestPoint_Pad_D1.0mm
TP6: PPS_BUF; TestPoint_Pad_D1.0mm
TP7: PPS_NANO; TestPoint_Pad_D1.0mm
TP8: 5V_CAPTURE; TestPoint_Pad_D1.0mm
TP9: 3V3_TCXO; TestPoint_Pad_D1.0mm
TP10: GND; TestPoint_Pad_D1.0mm
U1: 74AHCT2G125DP; TSSOP-8_3x3mm_P0.65mm; MPN 74AHCT2G125DP,125

Connections:
3V3_TCXO: TP9.1; also elsewhere on the board
5V_CAPTURE: TP8.1; also elsewhere on the board
GND: C7.2, C8.2, J2.1 (GND), J5.2 (GND), JP10.1 (A), JP11.2, TP10.1, U1.1; also elsewhere on the board
GNSS_VCC: C7.1, C8.1, J5.1 (5V_OUT); also elsewhere on the board
GPS_RX: J5.5 (GNSS_RX); also elsewhere on the board
GPS_TX: J2.3 (GNSS_TX_3V3), J5.4 (GNSS_TX); also elsewhere on the board
PPS_A: JP10.2 (C), U1.2
PPS_BIAS_RETURN: JP11.1, R5.2
PPS_BUF: JP9.3 (B), TP6.1, U1.6
PPS_NANO: JP9.2 (C), TP7.1; also elsewhere on the board
PPS_RAW: J2.2 (PPS_3V3), J5.3 (PPS_IN_3V3), R5.1, TP5.1; also elsewhere on the board
PPS_SELECTED: JP9.1 (A), JP10.3 (B); also elsewhere on the board

Notes on the sheet:
GNSS / PPS SELECTION
J5: selected3.3V/5V GNSS VCC; nominal3.3V PPS/UART. J2: read-only PPS/TX, no power. JP9 and JP10 must move together: 2-3 BUFFER default, 1-2 DIRECT comparison. JP11 normally OPEN: never load boot-shared GNSS PPS without receiver qualification.
