flynnr2/Arduino.Nano.Every.TickTock/Hardware/NanoEveryCarrierA9/NanoEveryCarrier.kicad_pcb

## KiCad design Hardware/NanoEveryCarrierA9/NanoEveryCarrier.kicad_pcb (continued)

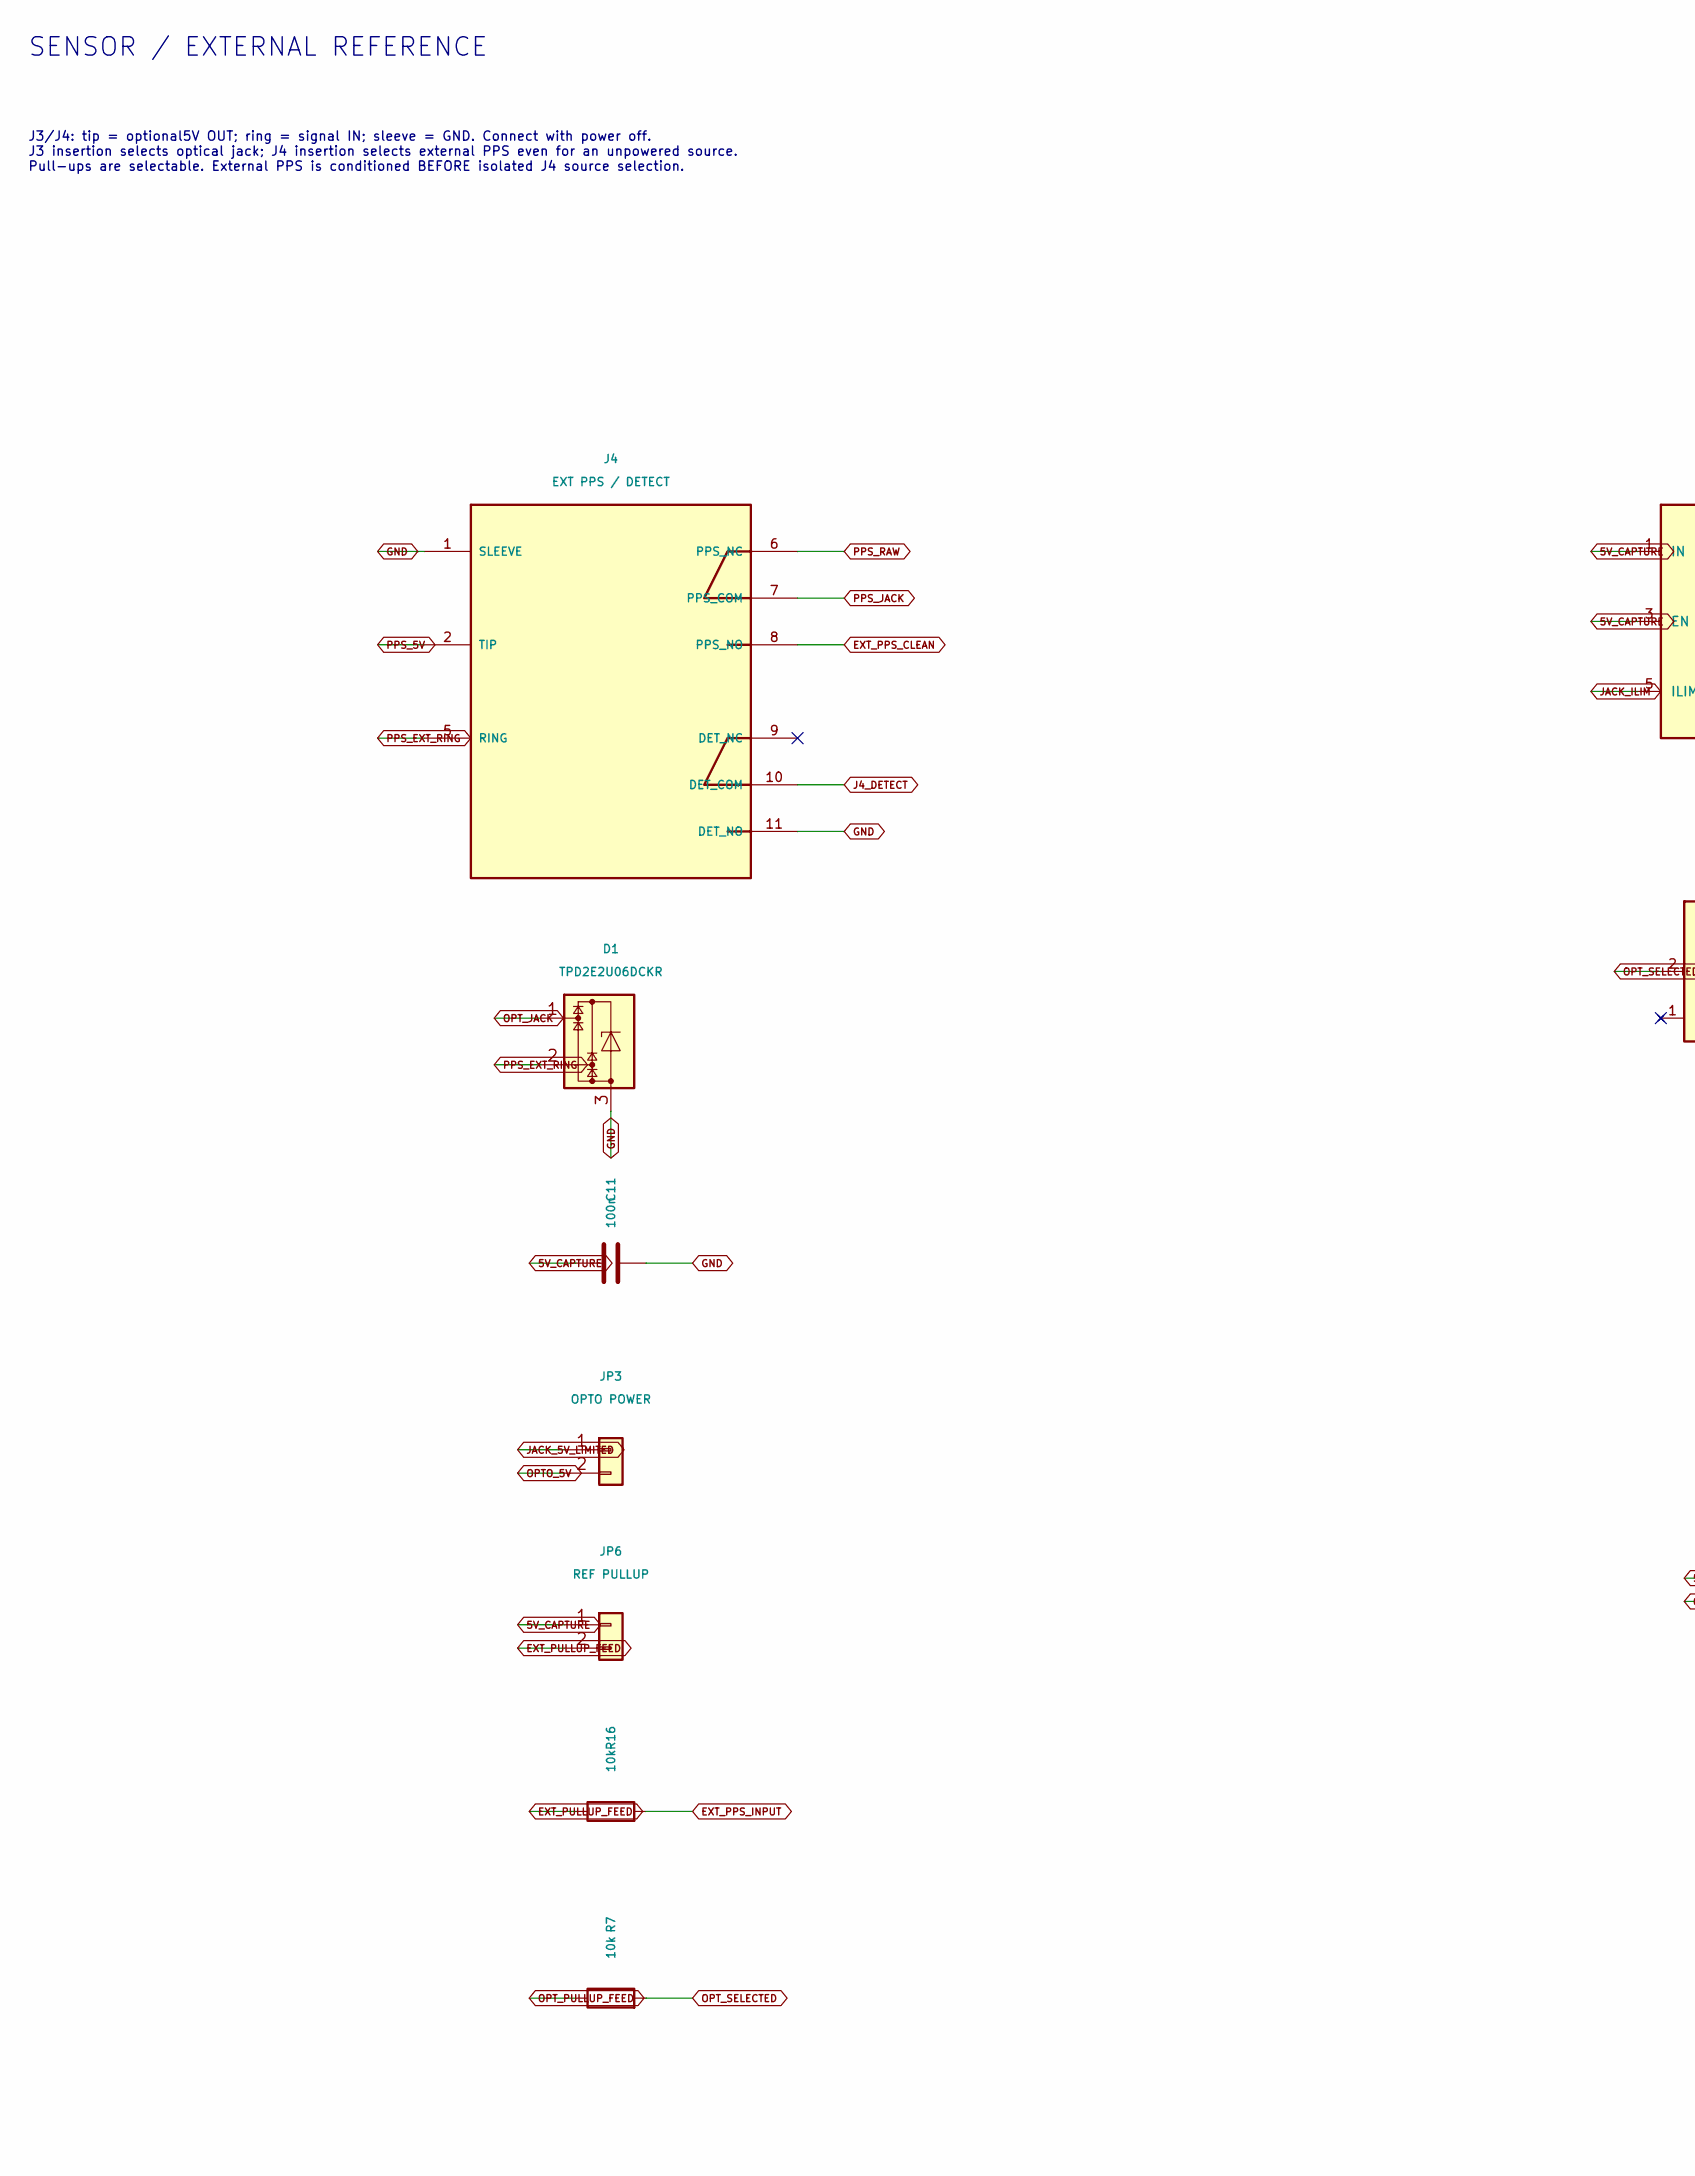
[picture p28: schematic JackInputs.kicad_sch, A.9 | SENSOR / EXTERNAL REFERENCE, part in row 1, column 1]

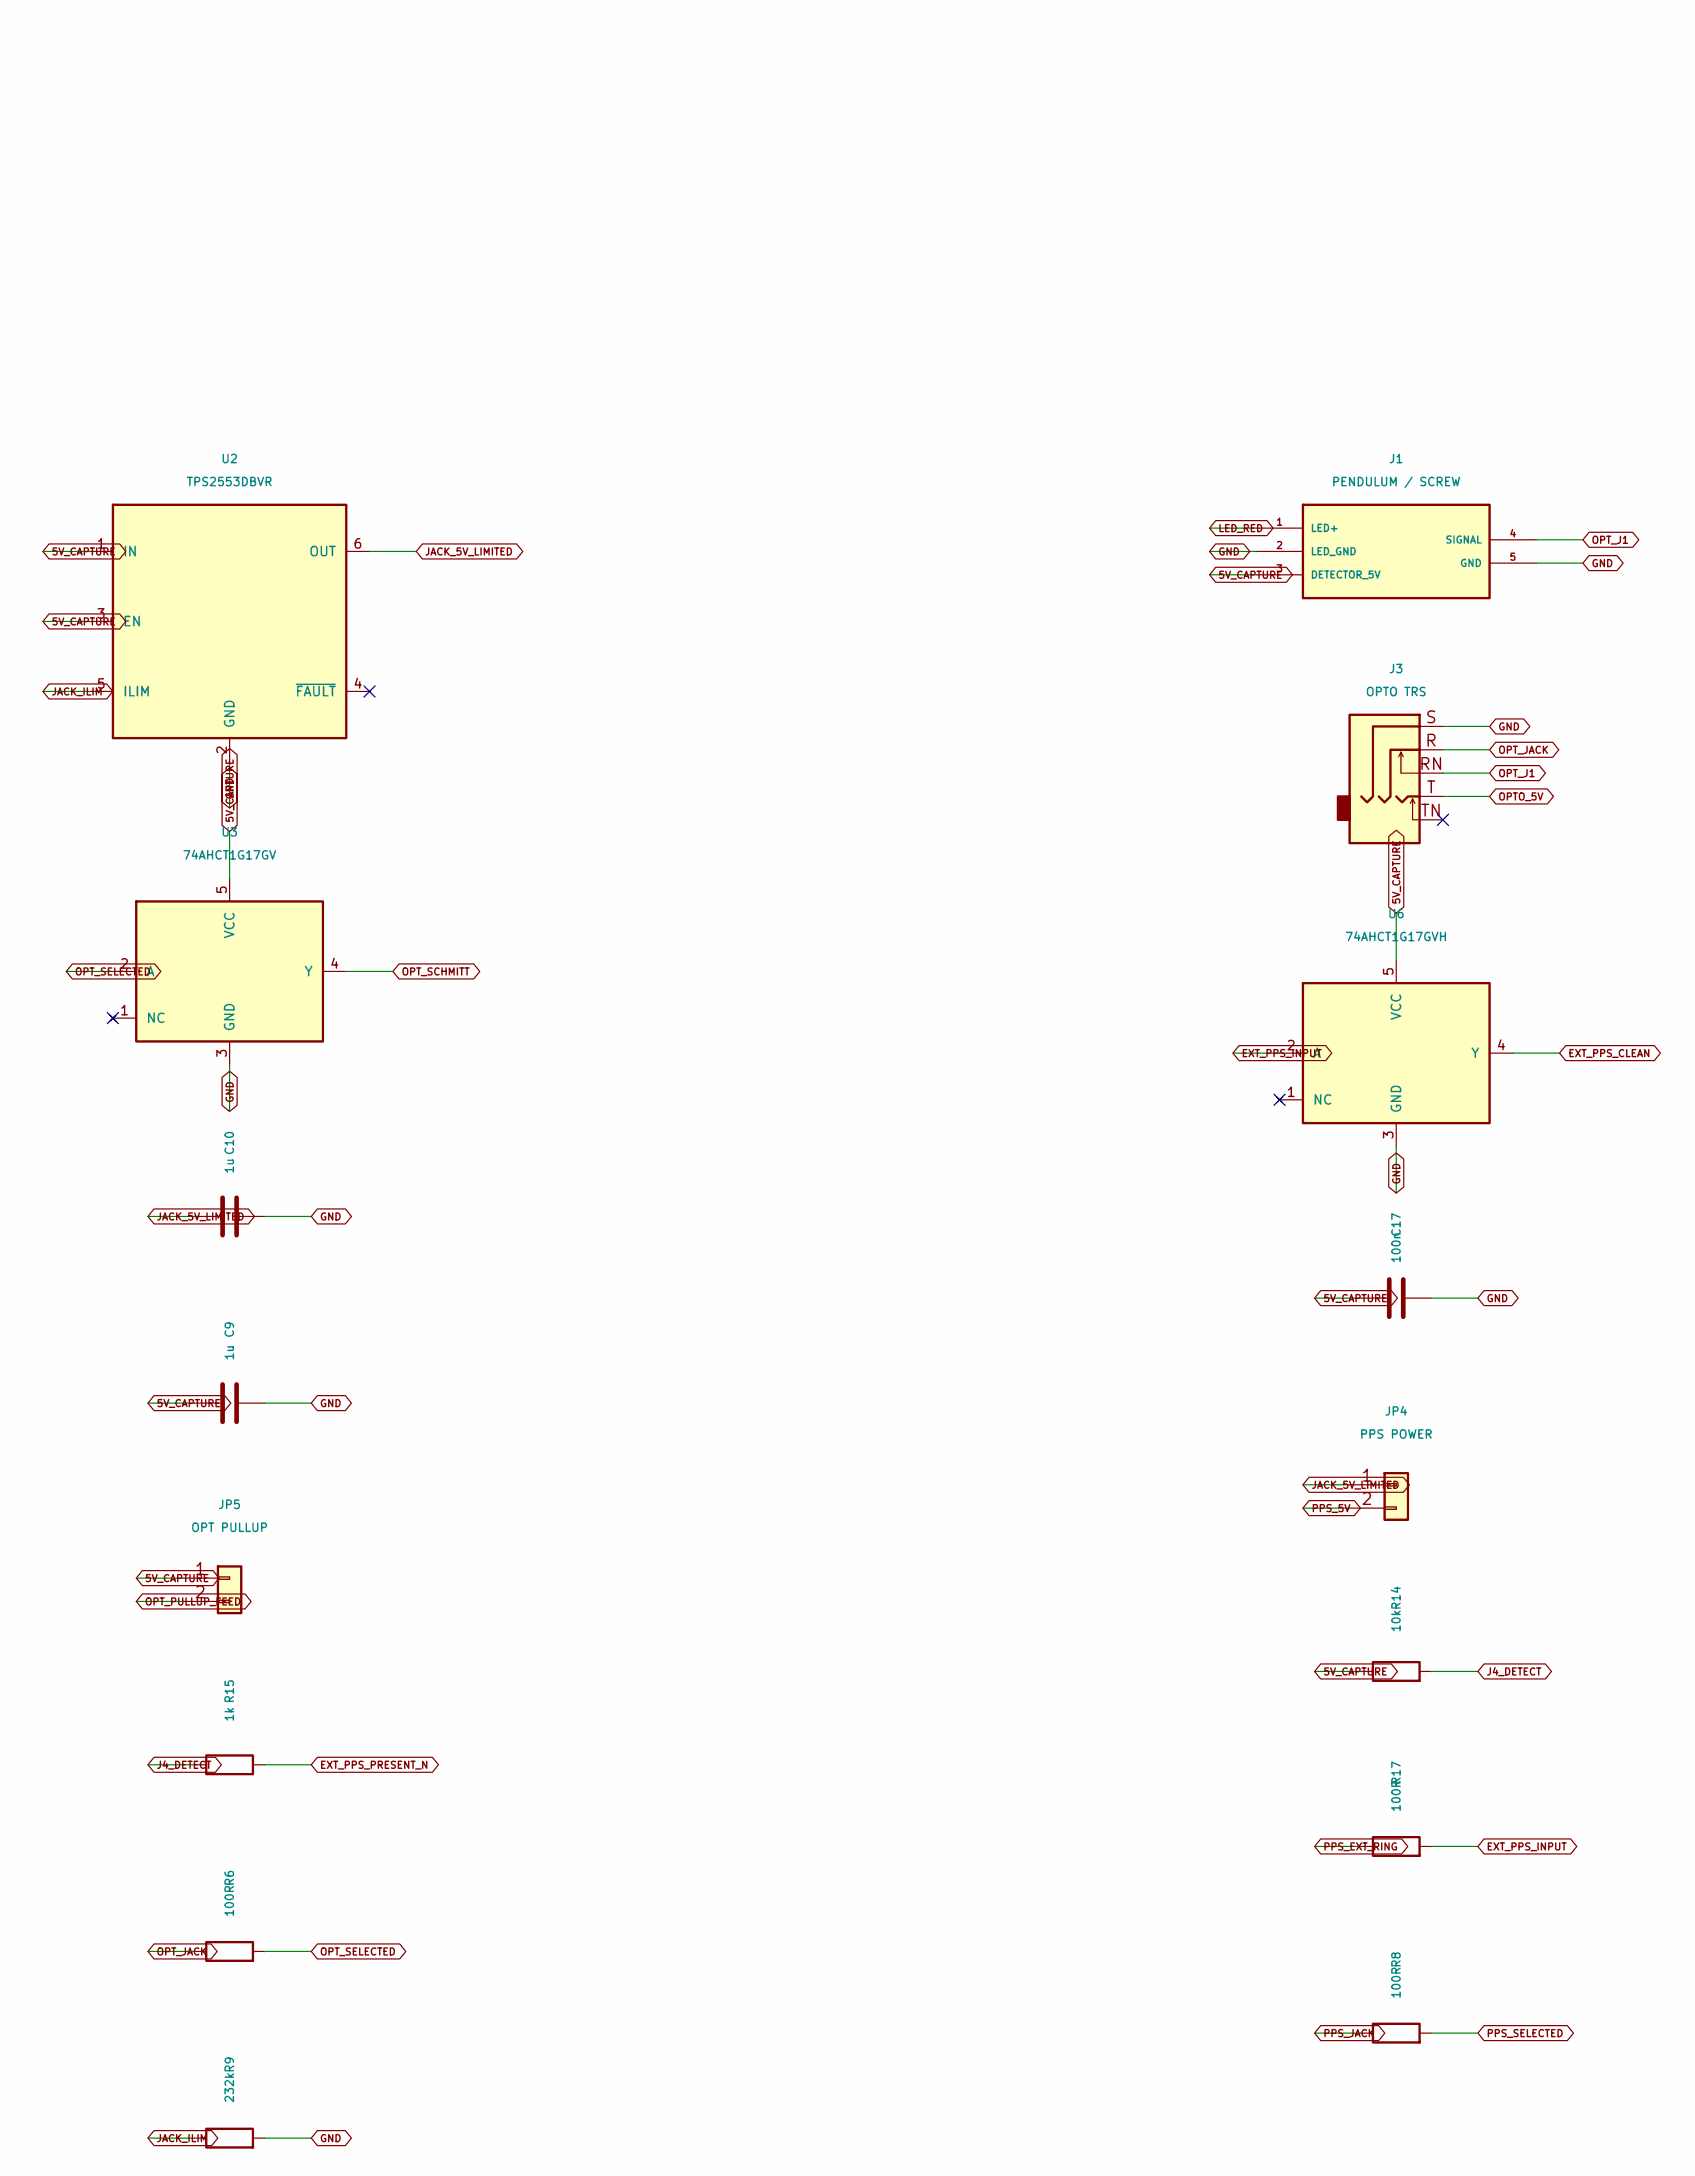
[picture p29: schematic JackInputs.kicad_sch, A.9 | SENSOR / EXTERNAL REFERENCE, part in row 1, column 2]

Parts:
C9, C10: 1u; C_0805_2012Metric; MPN GRM21BR71C105KA01L
C11, C17: 100n; C_0805_2012Metric; MPN GRM21BR71H104KA01L
D1: TPD2E2U06DCKR; SOT-323_SC-70; MPN TPD2E2U06DCKR
J1: PENDULUM / SCREW; Wurth_691210910005; MPN 691210910005
J3: OPTO TRS; Jack_3.5mm_CUI_SJ1-3535NG_Horizontal_CircularHoles; MPN SJ1-3535NG
J4: EXT PPS / DETECT; Jack_3.5mm_Kycon_STX-3100-9N; MPN STX-3100-9N
JP3: OPTO POWER; PinHeader_1x02_P2.54mm_Vertical; MPN TSW-102-07-G-S
JP4: PPS POWER; PinHeader_1x02_P2.54mm_Vertical; MPN TSW-102-07-G-S
JP5: OPT PULLUP; PinHeader_1x02_P2.54mm_Vertical; MPN TSW-102-07-G-S
JP6: REF PULLUP; PinHeader_1x02_P2.54mm_Vertical; MPN TSW-102-07-G-S
R6, R8: 100R; R_1206_3216Metric_Pad1.30x1.75mm_HandSolder; MPN RC1206FR-07100RL
R7: 10k; R_1206_3216Metric_Pad1.30x1.75mm_HandSolder; MPN RC1206FR-0710KL
R9: 232k; R_0805_2012Metric; MPN RC0805FR-07232KL
R14, R16: 10k; R_0805_2012Metric; MPN RC0805FR-0710KL
R15: 1k; R_0805_2012Metric; MPN RC0805FR-071KL
R17: 100R; R_0805_2012Metric; MPN RC0805FR-07100RL
U2: TPS2553DBVR; SOT-23-6; MPN TPS2553DBVR
U3: 74AHCT1G17GV; SOT-23-5; MPN 74AHCT1G17GVH
U6: 74AHCT1G17GVH; SOT-23-5; MPN 74AHCT1G17GVH

Connections:
5V_CAPTURE: C9.1, C11.1, C17.1, J1.3 (DETECTOR_5V), JP5.1, JP6.1, R14.1, U2.1 (IN), U2.3 (EN), U3.5 (VCC), U6.5 (VCC); also elsewhere on the board
EXT_PPS_CLEAN: J4.8 (PPS_NO), U6.4 (Y)
EXT_PPS_INPUT: R16.2, R17.2, U6.2 (A)
EXT_PPS_PRESENT_N: R15.2; also elsewhere on the board
EXT_PULLUP_FEED: JP6.2, R16.1
GND: C9.2, C10.2, C11.2, C17.2, D1.3, J1.2 (LED_GND), J1.5 (GND), J3.S, J4.1 (SLEEVE), J4.11 (DET_NO), R9.2, U2.2 (GND), U3.3 (GND), U6.3 (GND); also elsewhere on the board
J4_DETECT: J4.10 (DET_COM), R14.2, R15.1
JACK_5V_LIMITED: C10.1, JP3.1, JP4.1, U2.6 (OUT)
JACK_ILIM: R9.1, U2.5 (ILIM)
LED_RED: J1.1 (LED+); also elsewhere on the board
OPTO_5V: J3.T, JP3.2
OPT_J1: J1.4 (SIGNAL), J3.RN
OPT_JACK: D1.1, J3.R, R6.1
OPT_PULLUP_FEED: JP5.2, R7.1
OPT_SCHMITT: U3.4 (Y); also elsewhere on the board
OPT_SELECTED: R6.2, R7.2, U3.2 (A); also elsewhere on the board
PPS_5V: J4.2 (TIP), JP4.2
PPS_EXT_RING: D1.2, J4.5 (RING), R17.1
PPS_JACK: J4.7 (PPS_COM), R8.1
PPS_RAW: J4.6 (PPS_NC); also elsewhere on the board
PPS_SELECTED: R8.2; also elsewhere on the board

Notes on the sheet:
SENSOR / EXTERNAL REFERENCE
J3/J4: tip = optional5V OUT; ring = signal IN; sleeve = GND. Connect with power off. J3 insertion selects optical jack; J4 insertion selects external PPS even for an unpowered source. Pull-ups are selectable. External PPS is conditioned BEFORE isolated J4 source selection.

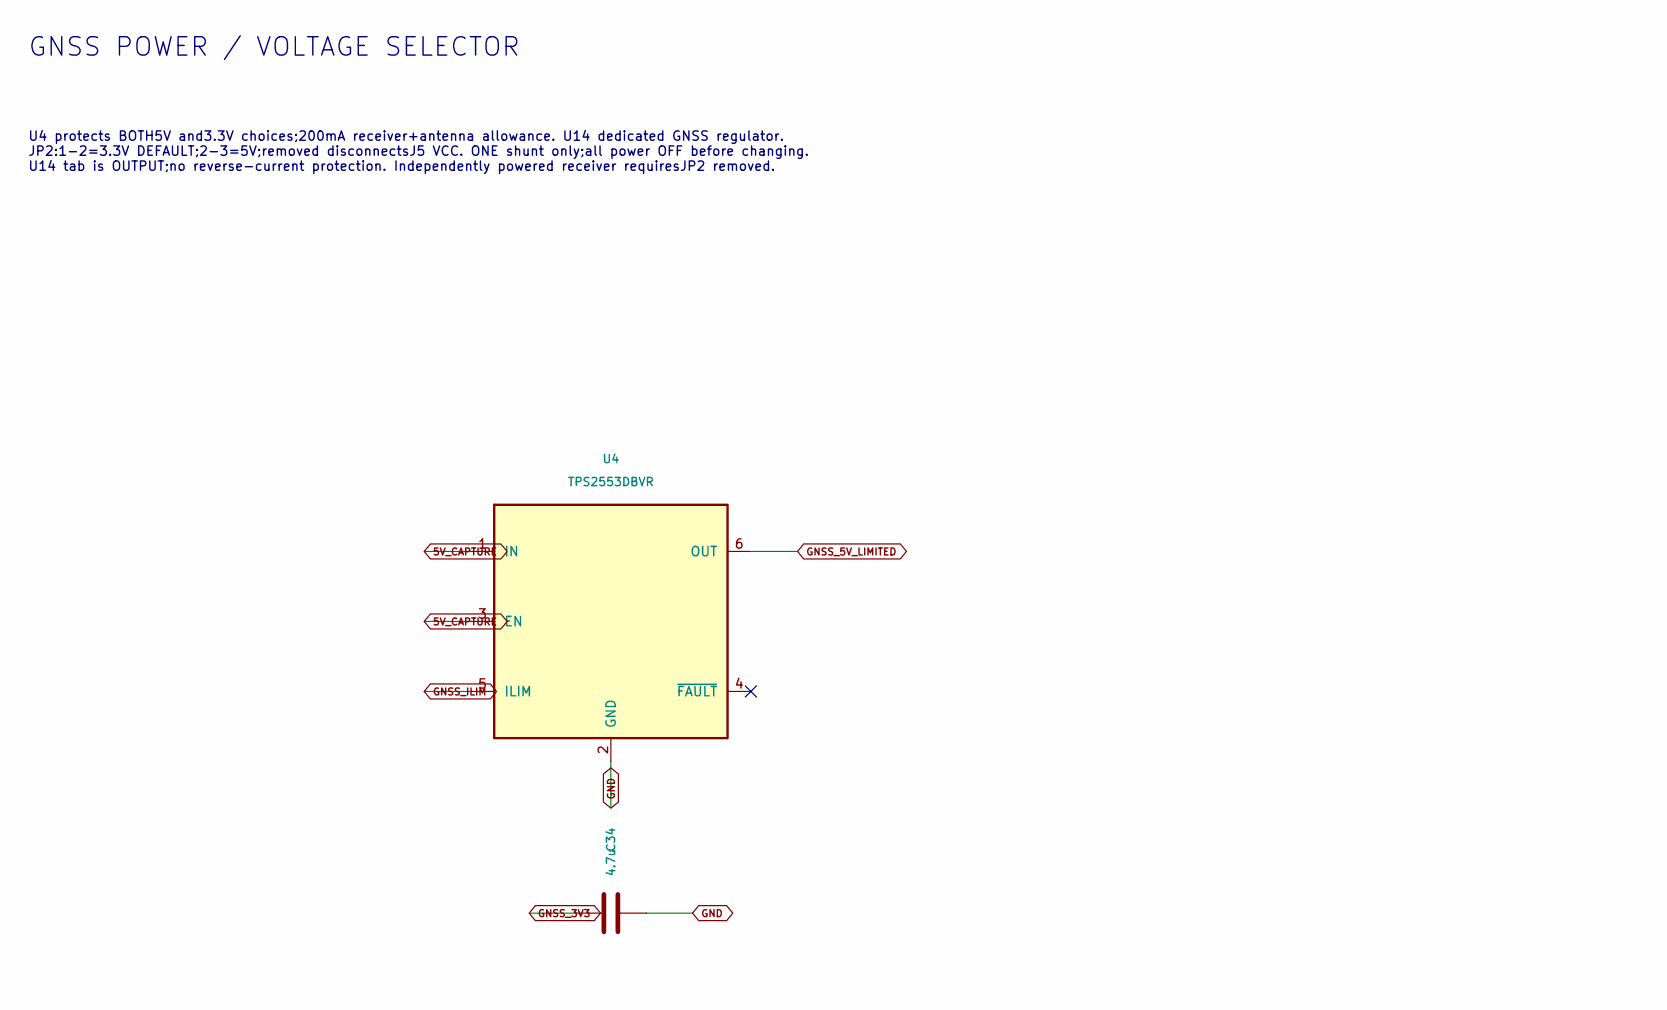
[picture p30: schematic GNSSPower.kicad_sch, A.9 | GNSS POWER / VOLTAGE SELECTOR, part in row 1, column 1]

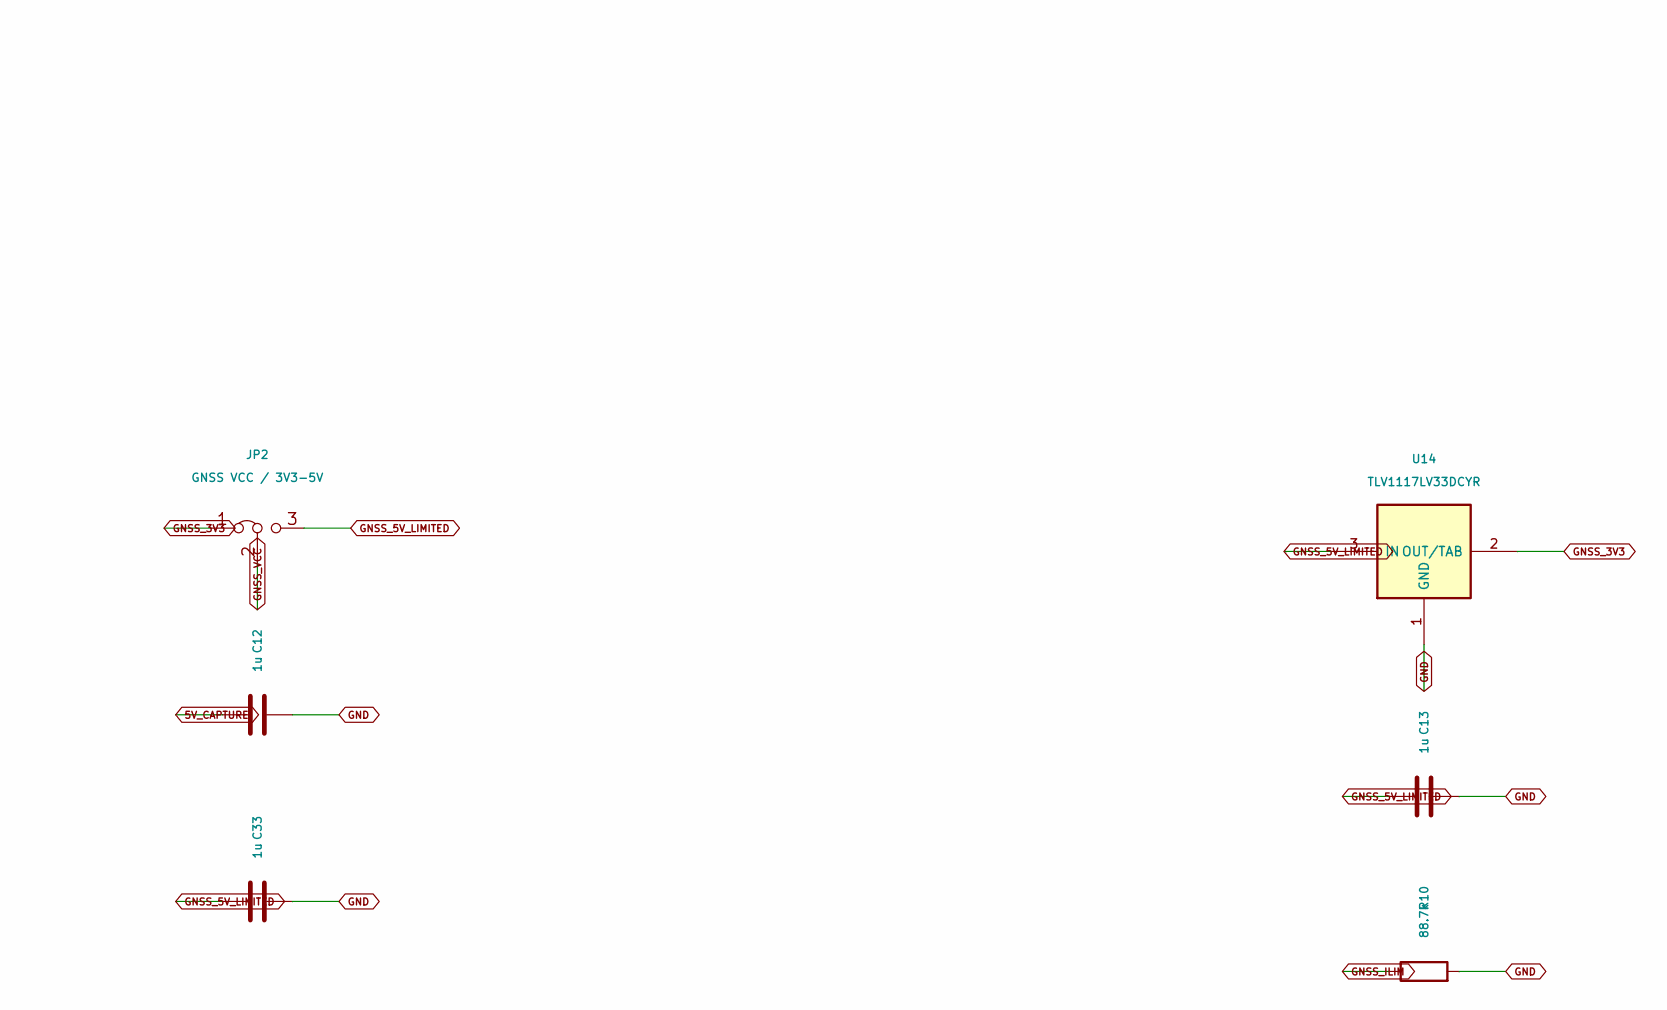
[picture p31: schematic GNSSPower.kicad_sch, A.9 | GNSS POWER / VOLTAGE SELECTOR, part in row 1, column 2]

Parts:
C12, C13, C33: 1u; C_0805_2012Metric; MPN GRM21BR71C105KA01L
C34: 4.7u; C_0805_2012Metric; MPN GRM21BR71C475KA73L
JP2: GNSS VCC / 3V3-5V; PinHeader_1x03_P2.54mm_Vertical; MPN TSW-103-07-G-S
R10: 88.7k; R_0805_2012Metric; MPN RC0805FR-0788K7L
U4: TPS2553DBVR; SOT-23-6; MPN TPS2553DBVR
U14: TLV1117LV33DCYR; SOT-223-3_TabPin2; MPN TLV1117LV33DCYR

Connections:
5V_CAPTURE: C12.1, U4.1 (IN), U4.3 (EN); also elsewhere on the board
GND: C12.2, C13.2, C33.2, C34.2, R10.2, U4.2 (GND), U14.1 (GND); also elsewhere on the board
GNSS_3V3: C34.1, JP2.1 (A), U14.2 (OUT/TAB)
GNSS_5V_LIMITED: C13.1, C33.1, JP2.3 (B), U4.6 (OUT), U14.3 (IN)
GNSS_ILIM: R10.1, U4.5 (ILIM)
GNSS_VCC: JP2.2 (C); also elsewhere on the board

Notes on the sheet:
GNSS POWER / VOLTAGE SELECTOR
U4 protects BOTH5V and3.3V choices;200mA receiver+antenna allowance. U14 dedicated GNSS regulator. JP2:1-2=3.3V DEFAULT;2-3=5V;removed disconnectsJ5 VCC. ONE shunt only;all power OFF before changing. U14 tab is OUTPUT;no reverse-current protection. Independently powered receiver requiresJP2 removed.

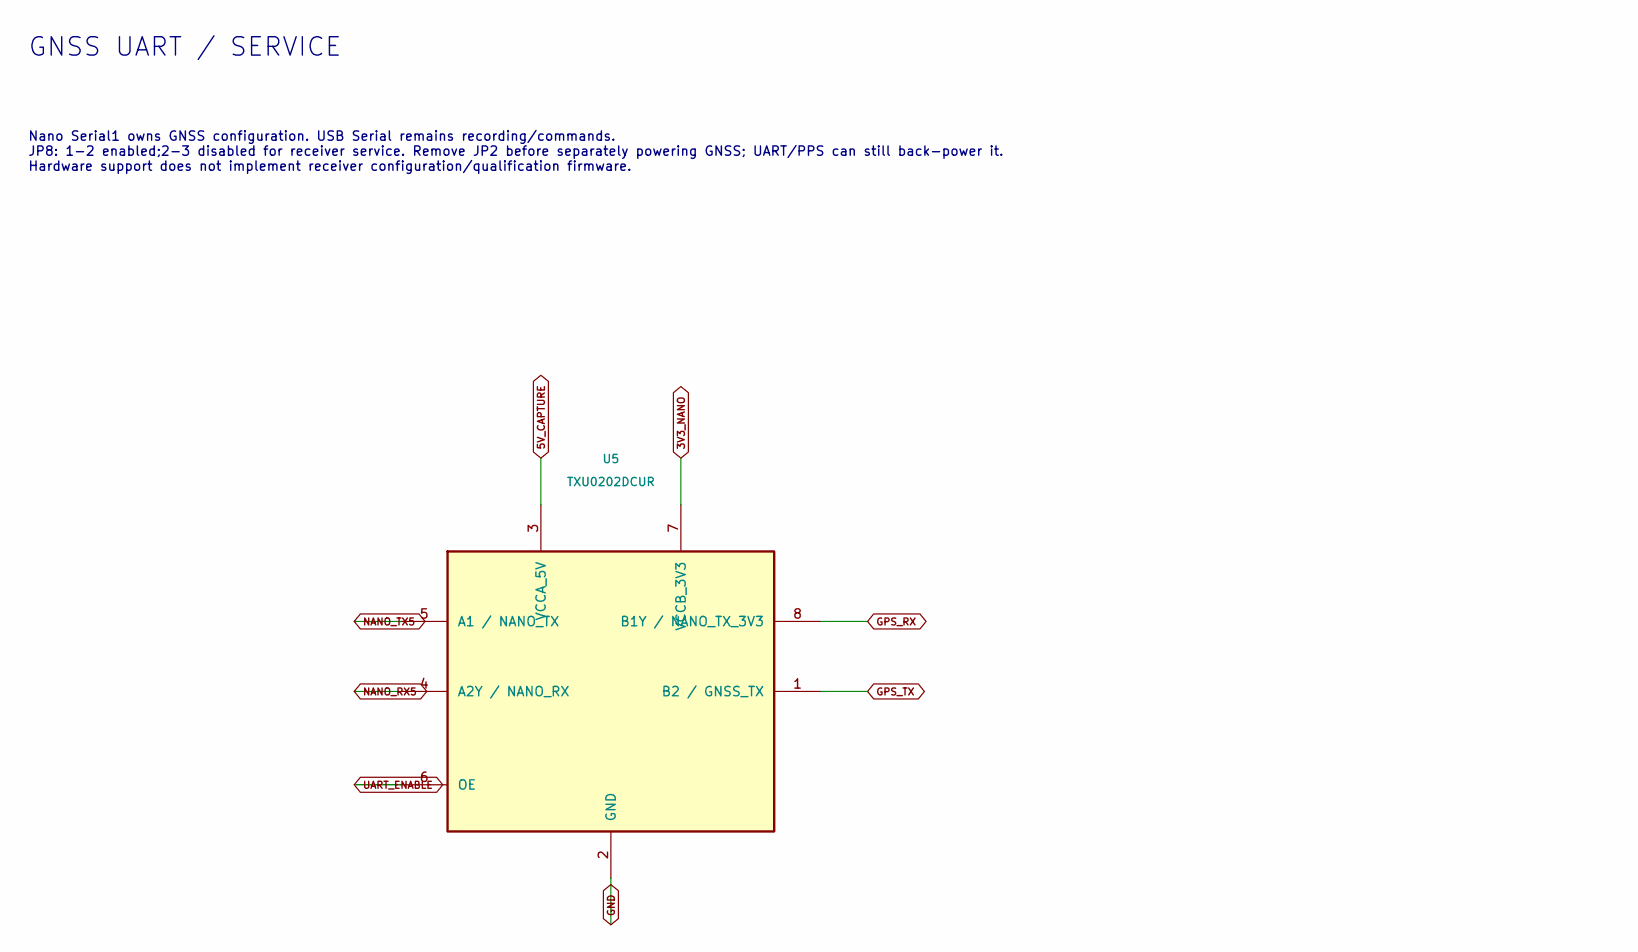
[picture p32: schematic GNSS_UART.kicad_sch, A.9 | GNSS UART / SERVICE, part in row 1, column 1]

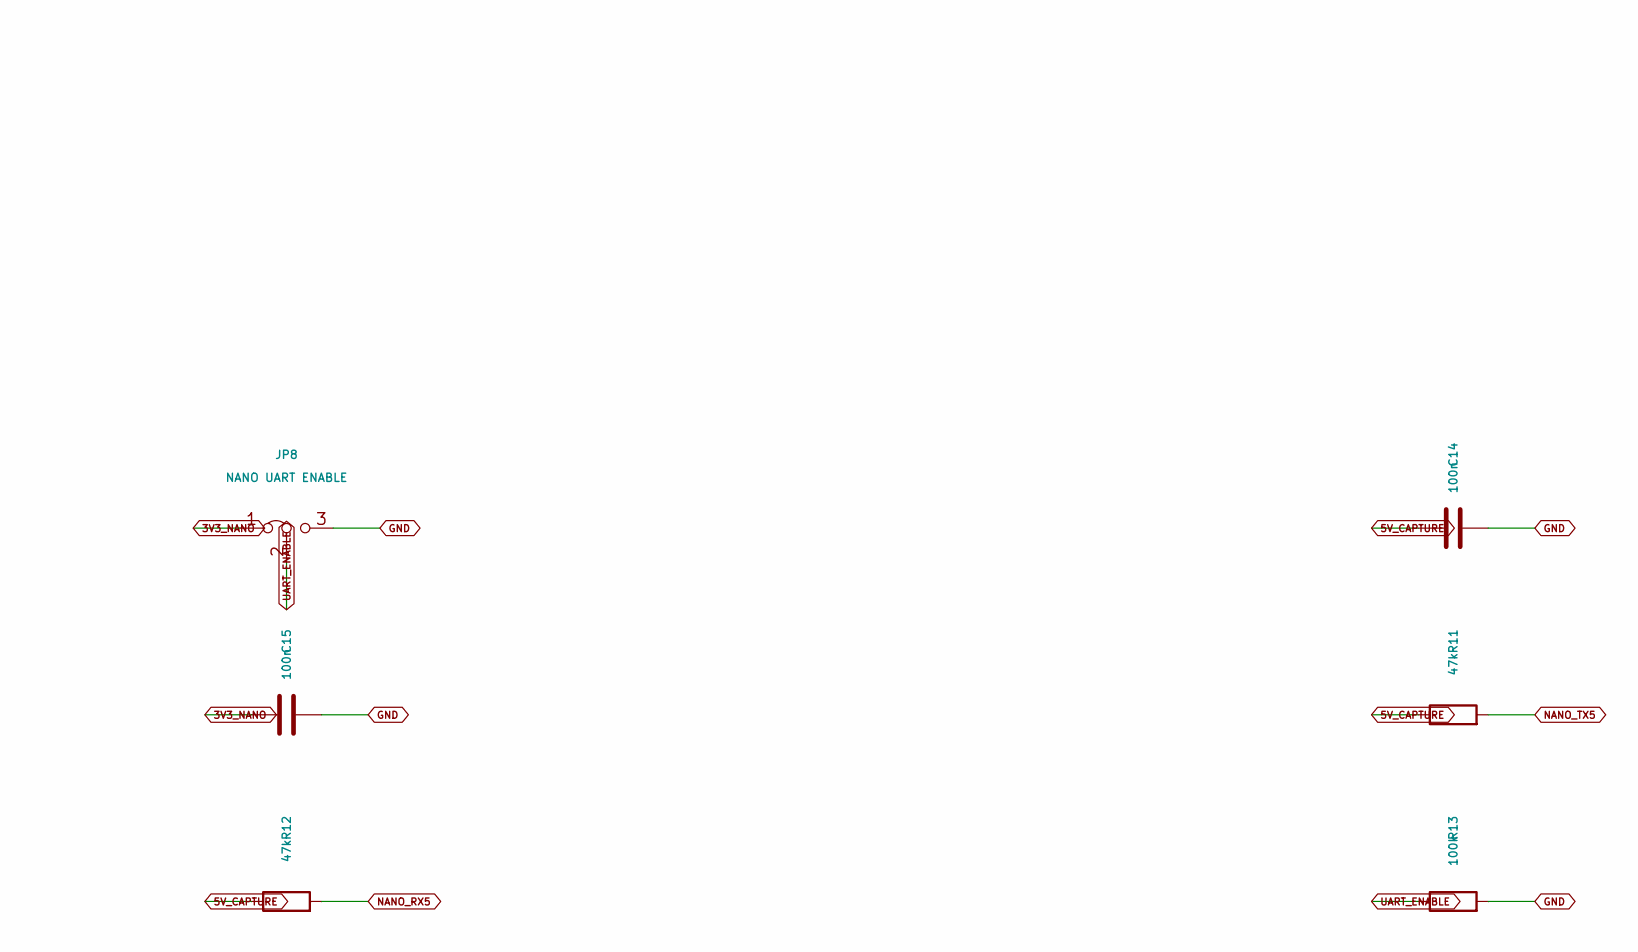
[picture p33: schematic GNSS_UART.kicad_sch, A.9 | GNSS UART / SERVICE, part in row 1, column 2]

Parts:
C14, C15: 100n; C_0805_2012Metric; MPN GRM21BR71H104KA01L
JP8: NANO UART ENABLE; PinHeader_1x03_P2.54mm_Vertical; MPN TSW-103-07-G-S
R11, R12: 47k; R_0805_2012Metric; MPN RC0805FR-0747KL
R13: 100k; R_0805_2012Metric; MPN RC0805FR-07100KL
U5: TXU0202DCUR; TI_DCU0008A_VSSOP-8_2.3x2mm_P0.5mm; MPN TXU0202DCUR

Connections:
3V3_NANO: C15.1, JP8.1 (A), U5.7 (VCCB_3V3); also elsewhere on the board
5V_CAPTURE: C14.1, R11.1, R12.1, U5.3 (VCCA_5V); also elsewhere on the board
GND: C14.2, C15.2, JP8.3 (B), R13.2, U5.2 (GND); also elsewhere on the board
GPS_RX: U5.8 (B1Y / NANO_TX_3V3); also elsewhere on the board
GPS_TX: U5.1 (B2 / GNSS_TX); also elsewhere on the board
NANO_RX5: R12.2, U5.4 (A2Y / NANO_RX); also elsewhere on the board
NANO_TX5: R11.2, U5.5 (A1 / NANO_TX); also elsewhere on the board
UART_ENABLE: JP8.2 (C), R13.1, U5.6 (OE)

Notes on the sheet:
GNSS UART / SERVICE
Nano Serial1 owns GNSS configuration. USB Serial remains recording/commands. JP8: 1-2 enabled;2-3 disabled for receiver service. Remove JP2 before separately powering GNSS; UART/PPS can still back-power it. Hardware support does not implement receiver configuration/qualification firmware.
