flynnr2/Arduino.Nano.Every.TickTock/Hardware/NanoEveryCarrierA9/NanoEveryCarrier.kicad_pcb

## KiCad design Hardware/NanoEveryCarrierA9/NanoEveryCarrier.kicad_pcb (continued)

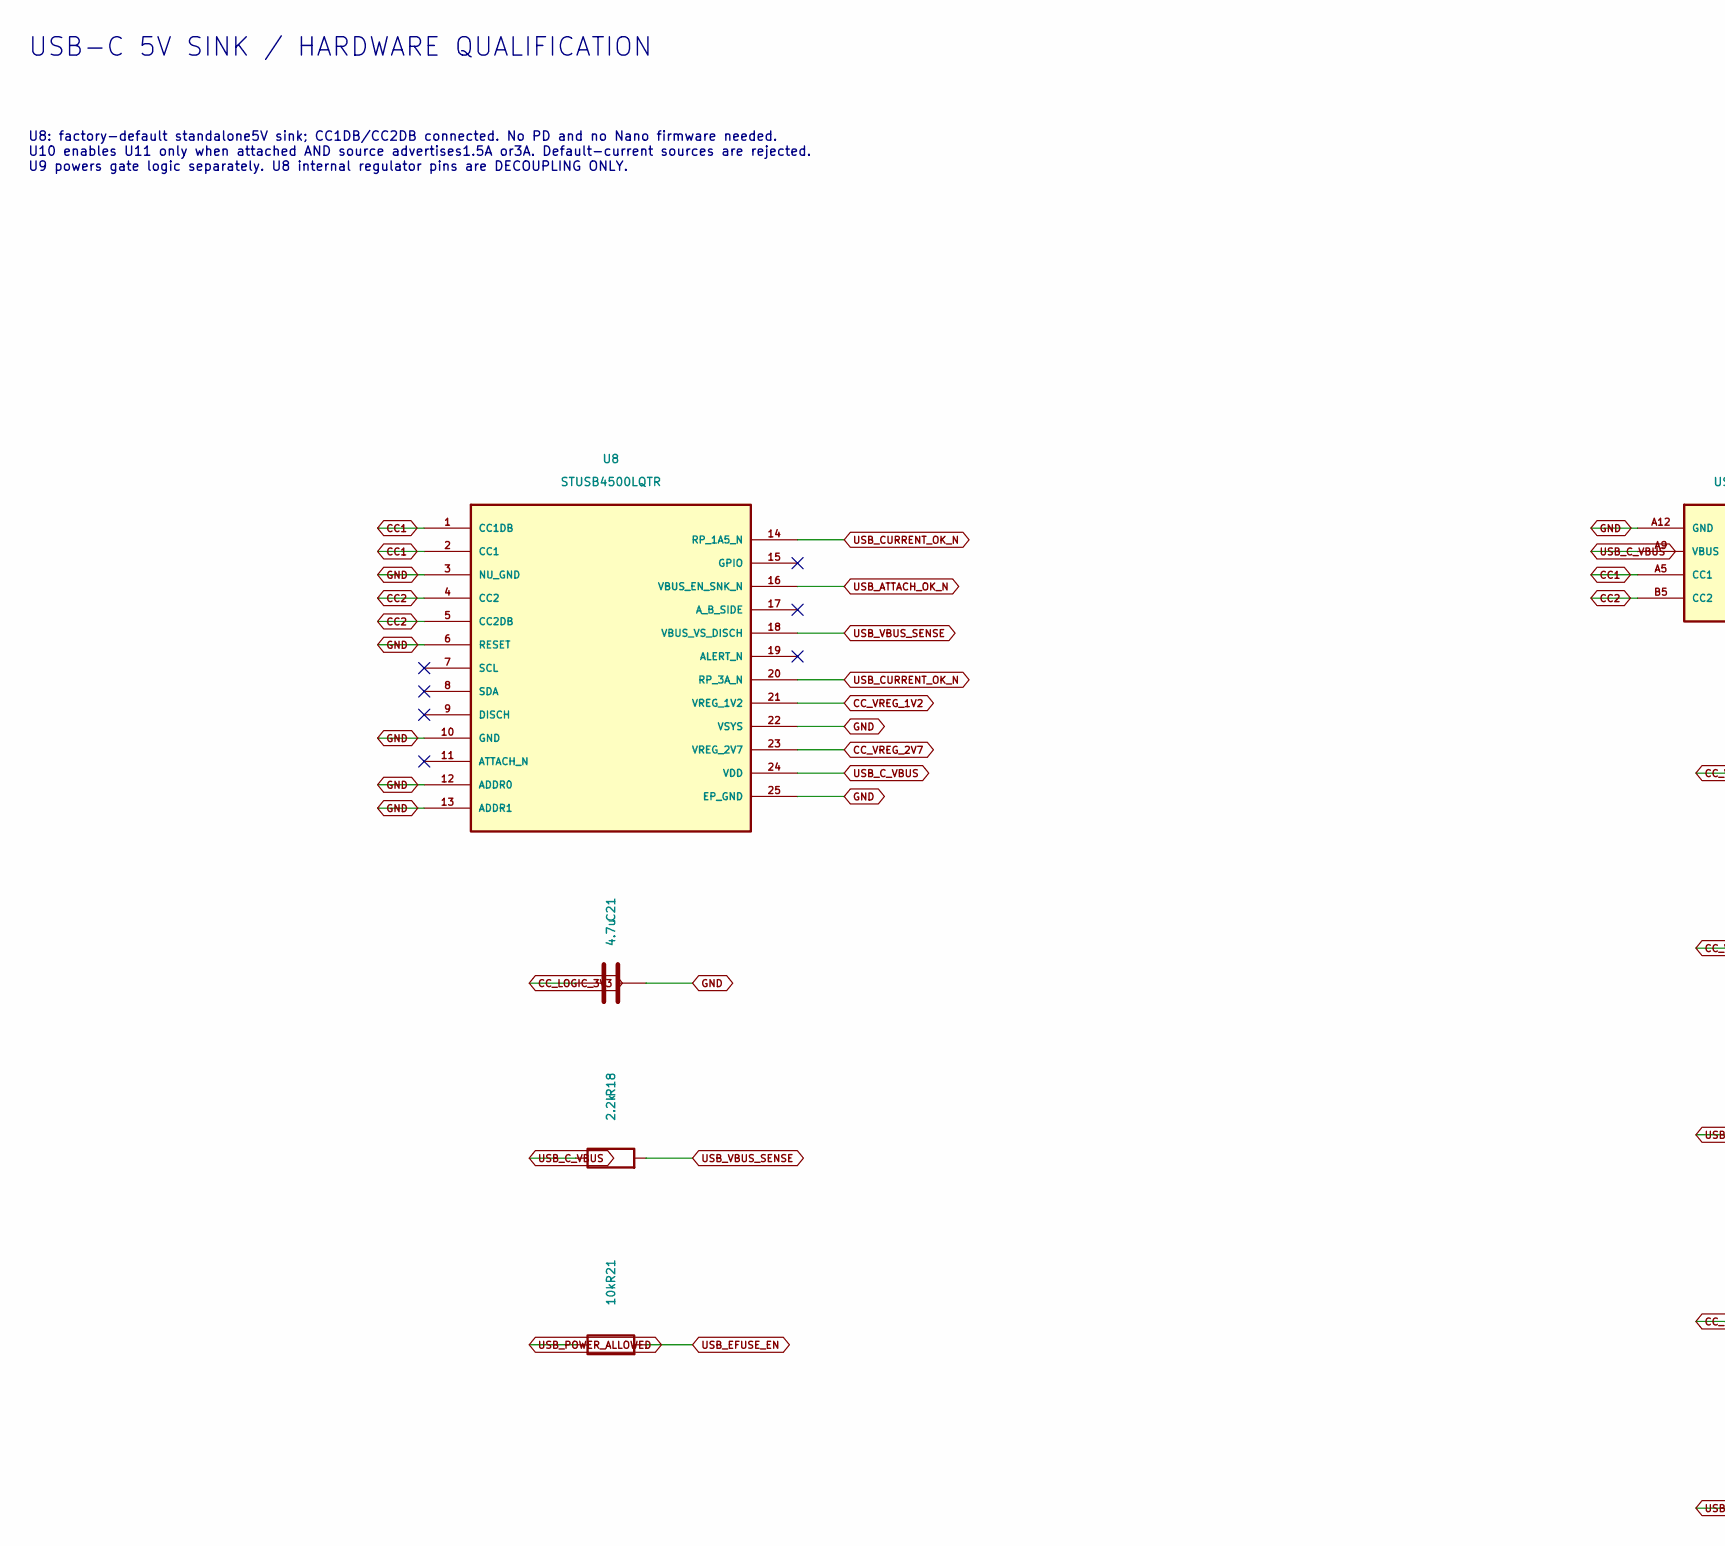
[picture p34: schematic USBPower.kicad_sch, A.9 | USB-C 5V SINK / HARDWARE QUALIFICATION, part in row 1, column 1]

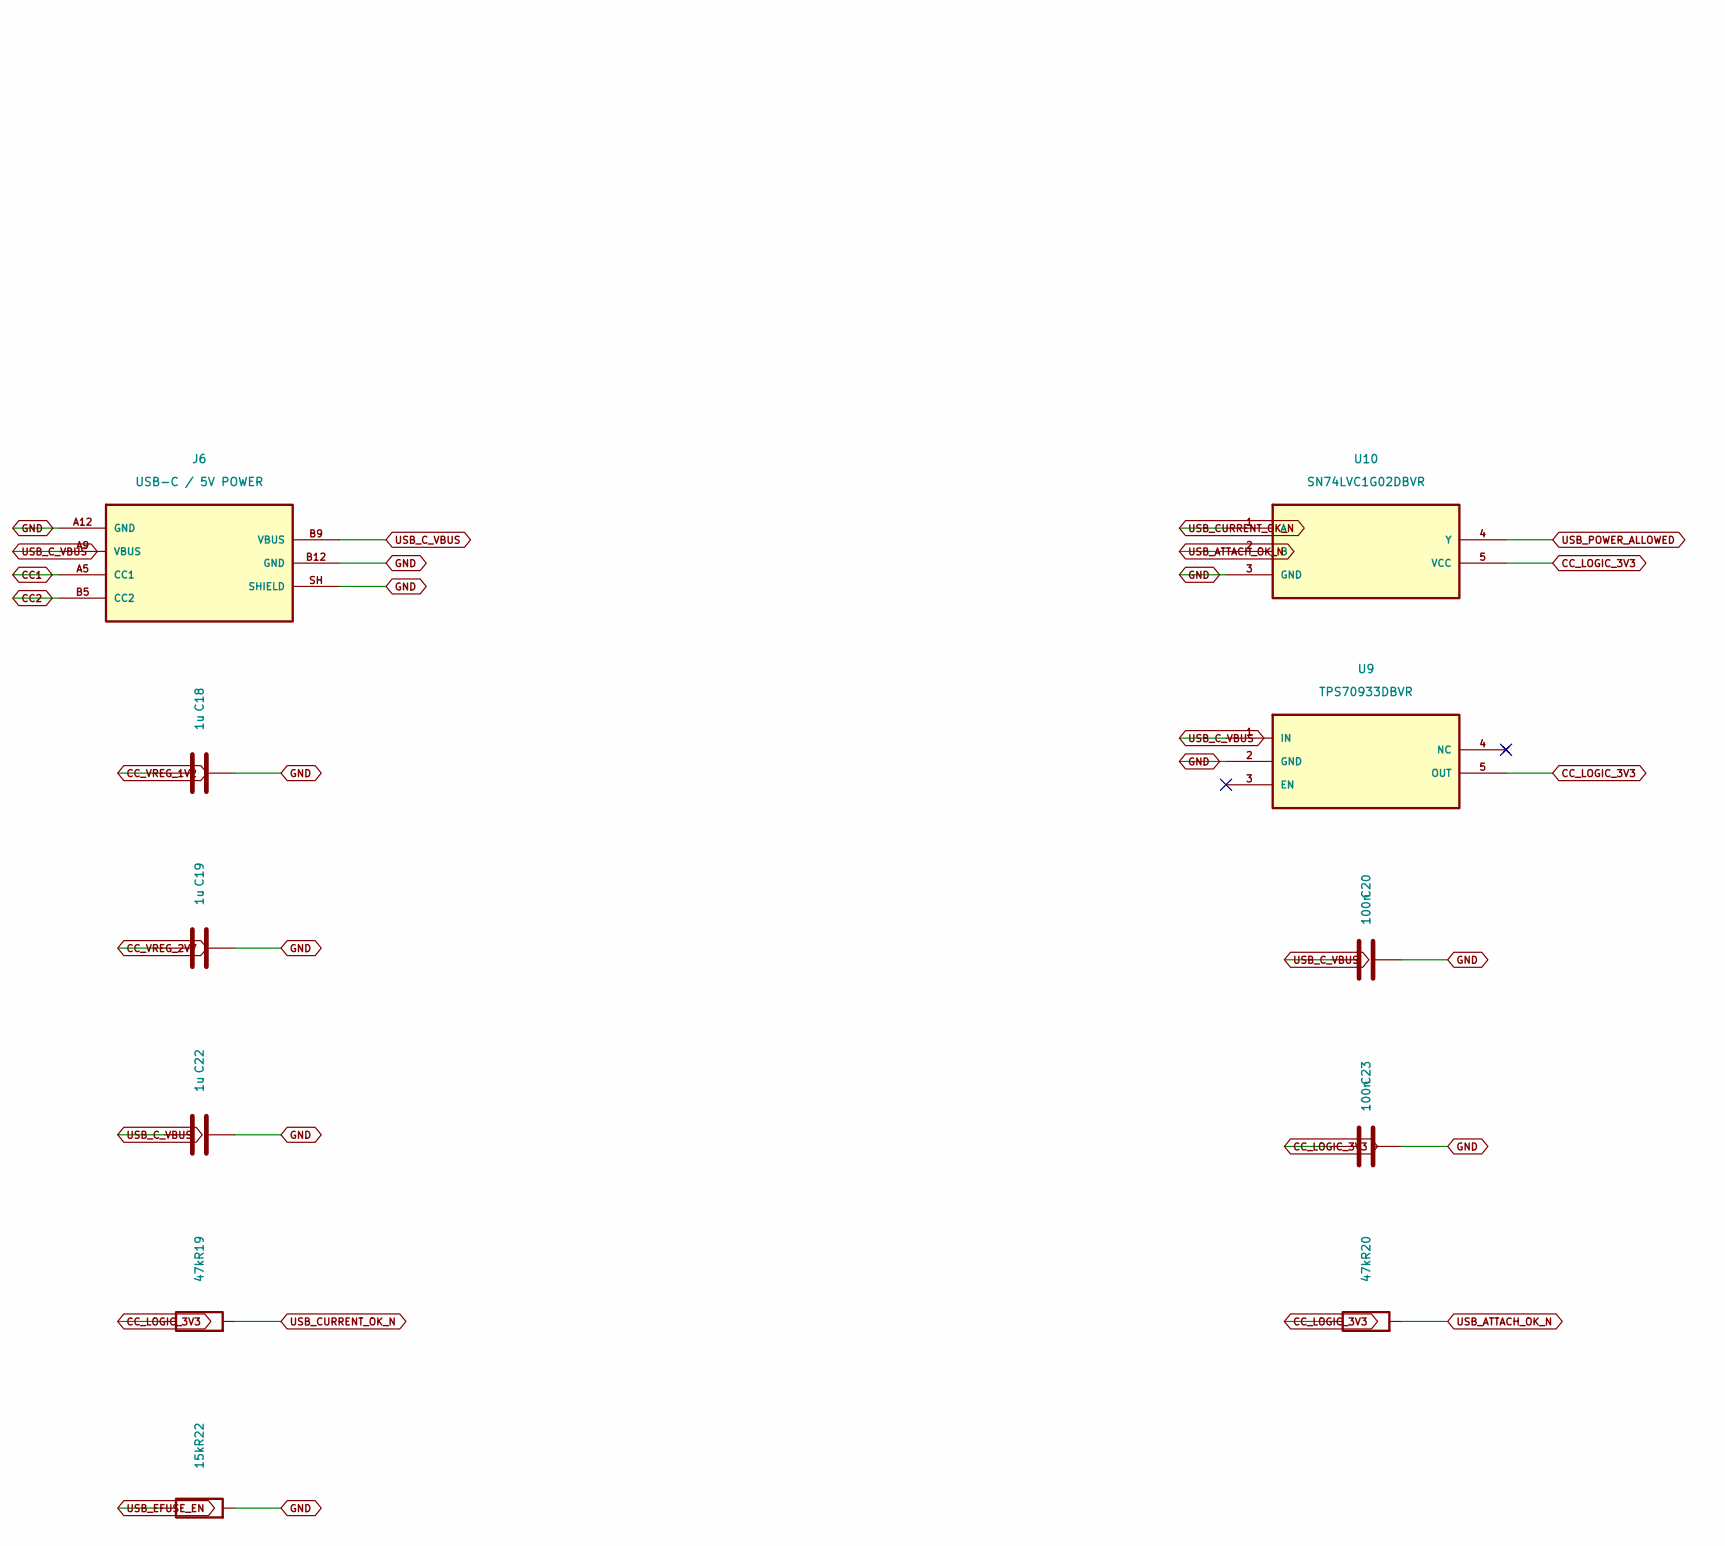
[picture p35: schematic USBPower.kicad_sch, A.9 | USB-C 5V SINK / HARDWARE QUALIFICATION, part in row 1, column 2]

Parts:
C18, C19: 1u; C_0805_2012Metric; MPN GRM21BR71C105KA01L
C20, C23: 100n; C_0805_2012Metric; MPN GRM21BR71H104KA01L
C21: 4.7u; C_0805_2012Metric; MPN GRM21BR71C475KA73L
C22: 1u; C_0805_2012Metric; MPN GRM21BR71H105KA12L
J6: USB-C / 5V POWER; USB_C_Receptacle_GCT_USB4125-xx-x-0190_6P_TopMnt_Horizontal; MPN USB4125-GF-A-0190
R18: 2.2k; R_1206_3216Metric_Pad1.30x1.75mm_HandSolder; MPN RC1206FR-072K2L
R19, R20: 47k; R_0805_2012Metric; MPN RC0805FR-0747KL
R21: 10k; R_0805_2012Metric; MPN RC0805FR-0710KL
R22: 15k; R_0805_2012Metric; MPN RC0805FR-0715KL
U8: STUSB4500LQTR; QFN-24-1EP_4x4mm_P0.5mm_EP2.6x2.6mm; MPN STUSB4500LQTR
U9: TPS70933DBVR; SOT-23-5; MPN TPS70933DBVR
U10: SN74LVC1G02DBVR; SOT-23-5; MPN SN74LVC1G02DBVR

Connections:
CC1: J6.A5 (CC1), U8.1 (CC1DB), U8.2 (CC1)
CC2: J6.B5 (CC2), U8.4 (CC2), U8.5 (CC2DB)
CC_LOGIC_3V3: C21.1, C23.1, R19.1, R20.1, U9.5 (OUT), U10.5 (VCC)
CC_VREG_1V2: C18.1, U8.21 (VREG_1V2)
CC_VREG_2V7: C19.1, U8.23 (VREG_2V7)
GND: C18.2, C19.2, C20.2, C21.2, C22.2, C23.2, J6.A12 (GND), J6.B12 (GND), J6.SH (SHIELD), R22.2, U8.3 (NU_GND), U8.6 (RESET), U8.10 (GND), U8.12 (ADDR0), U8.13 (ADDR1), U8.22 (VSYS), U8.25 (EP_GND), U9.2 (GND), U10.3 (GND); also elsewhere on the board
USB_ATTACH_OK_N: R20.2, U8.16 (VBUS_EN_SNK_N), U10.2 (B)
USB_CURRENT_OK_N: R19.2, U8.14 (RP_1A5_N), U8.20 (RP_3A_N), U10.1 (A)
USB_C_VBUS: C20.1, C22.1, J6.A9 (VBUS), J6.B9 (VBUS), R18.1, U8.24 (VDD), U9.1 (IN); also elsewhere on the board
USB_EFUSE_EN: R21.2, R22.1; also elsewhere on the board
USB_POWER_ALLOWED: R21.1, U10.4 (Y)
USB_VBUS_SENSE: R18.2, U8.18 (VBUS_VS_DISCH)

Notes on the sheet:
USB-C 5V SINK / HARDWARE QUALIFICATION
U8: factory-default standalone5V sink; CC1DB/CC2DB connected. No PD and no Nano firmware needed. U10 enables U11 only when attached AND source advertises1.5A or3A. Default-current sources are rejected. U9 powers gate logic separately. U8 internal regulator pins are DECOUPLING ONLY.

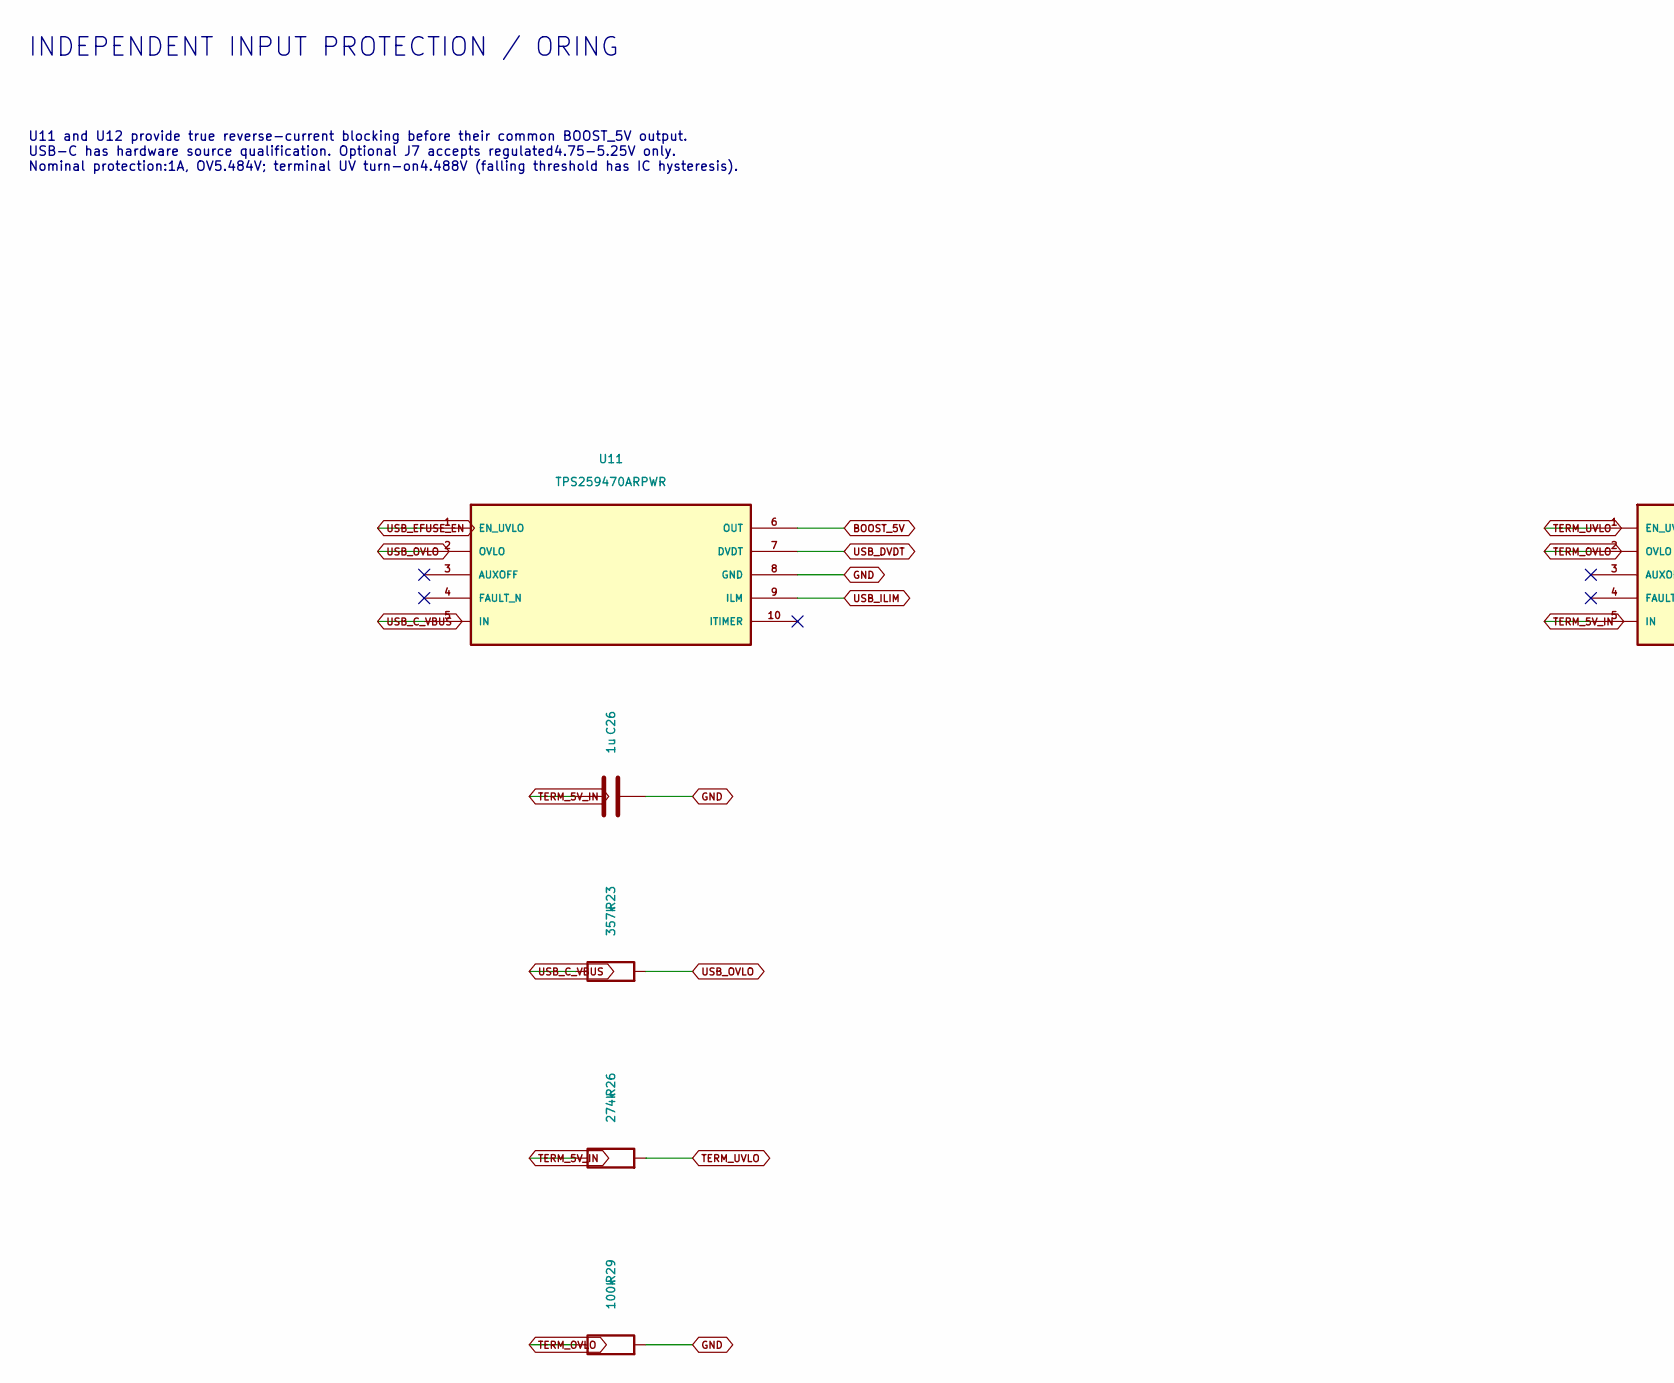
[picture p36: schematic PowerProtection.kicad_sch, A.9 | INDEPENDENT INPUT PROTECTION / ORING, part in row 1, column 1]

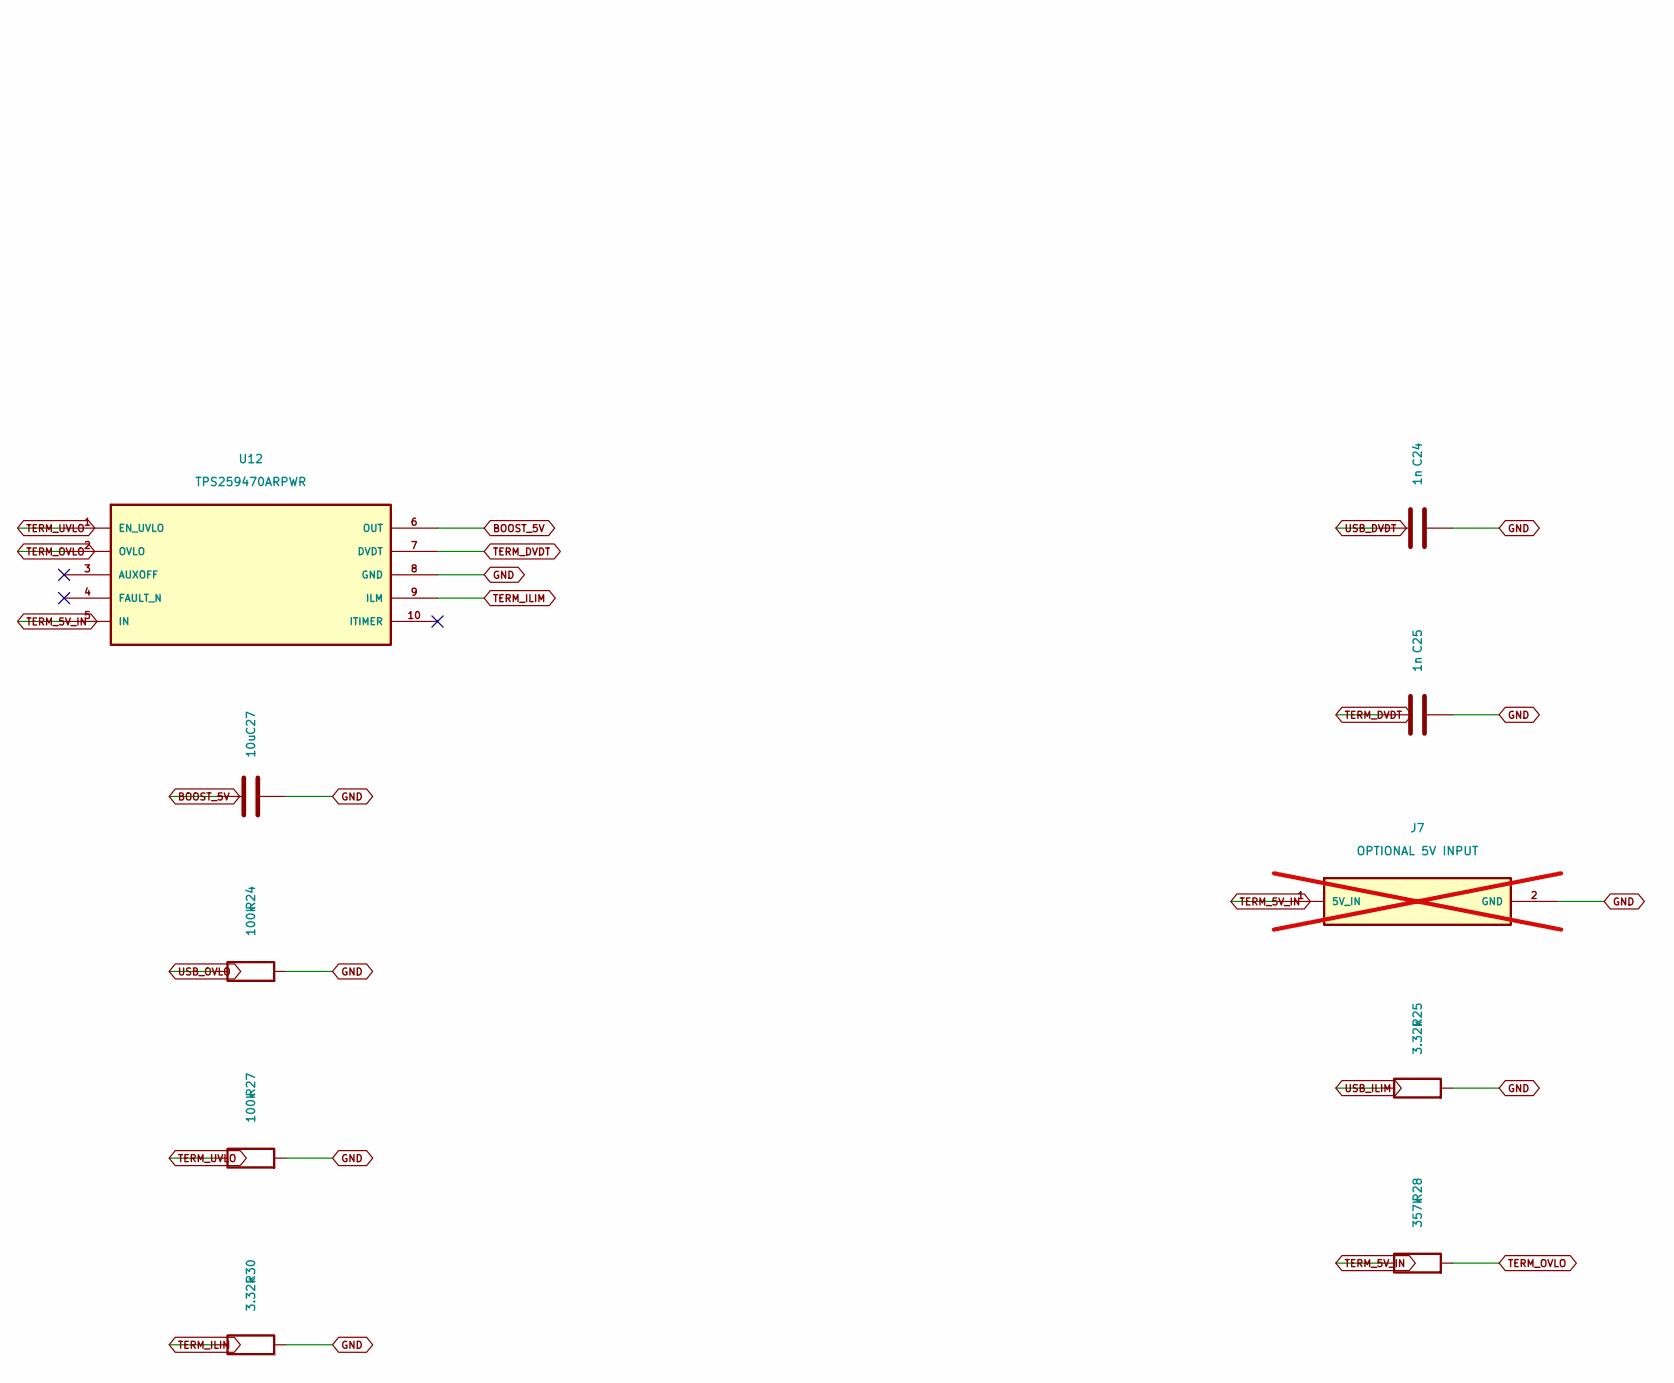
[picture p37: schematic PowerProtection.kicad_sch, A.9 | INDEPENDENT INPUT PROTECTION / ORING, part in row 1, column 2]

Parts:
C24, C25: 1n; C_0805_2012Metric; MPN GRM21B5C1H102JA01L
C26: 1u; C_0805_2012Metric; MPN GRM21BR71H105KA12L
C27: 10u; C_0805_2012Metric; MPN GRM21BR61C106KE15L
J7: OPTIONAL 5V INPUT; TerminalBlock_Phoenix_MKDS-1,5-2-5.08_1x02_P5.08mm_Horizont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; MPN 1715721; not fitted
R23, R28: 357k; R_0805_2012Metric; MPN RC0805FR-07357KL
R24, R27, R29: 100k; R_0805_2012Metric; MPN RC0805FR-07100KL
R25, R30: 3.32k; R_0805_2012Metric; MPN RC0805FR-073K32L
R26: 274k; R_0805_2012Metric; MPN RC0805FR-07274KL
U11, U12: TPS259470ARPWR; TI_RPW0010A; MPN TPS259470ARPWR

Connections:
BOOST_5V: C27.1, U11.6 (OUT), U12.6 (OUT); also elsewhere on the board
GND: C24.2, C25.2, C26.2, C27.2, J7.2 (GND), R24.2, R25.2, R27.2, R29.2, R30.2, U11.8 (GND), U12.8 (GND); also elsewhere on the board
TERM_5V_IN: C26.1, J7.1 (5V_IN), R26.1, R28.1, U12.5 (IN)
TERM_DVDT: C25.1, U12.7 (DVDT)
TERM_ILIM: R30.1, U12.9 (ILM)
TERM_OVLO: R28.2, R29.1, U12.2 (OVLO)
TERM_UVLO: R26.2, R27.1, U12.1 (EN_UVLO)
USB_C_VBUS: R23.1, U11.5 (IN); also elsewhere on the board
USB_DVDT: C24.1, U11.7 (DVDT)
USB_EFUSE_EN: U11.1 (EN_UVLO); also elsewhere on the board
USB_ILIM: R25.1, U11.9 (ILM)
USB_OVLO: R23.2, R24.1, U11.2 (OVLO)

Notes on the sheet:
INDEPENDENT INPUT PROTECTION / ORING
U11 and U12 provide true reverse-current blocking before their common BOOST_5V output. USB-C has hardware source qualification. Optional J7 accepts regulated4.75-5.25V only. Nominal protection:1A, OV5.484V; terminal UV turn-on4.488V (falling threshold has IC hysteresis).

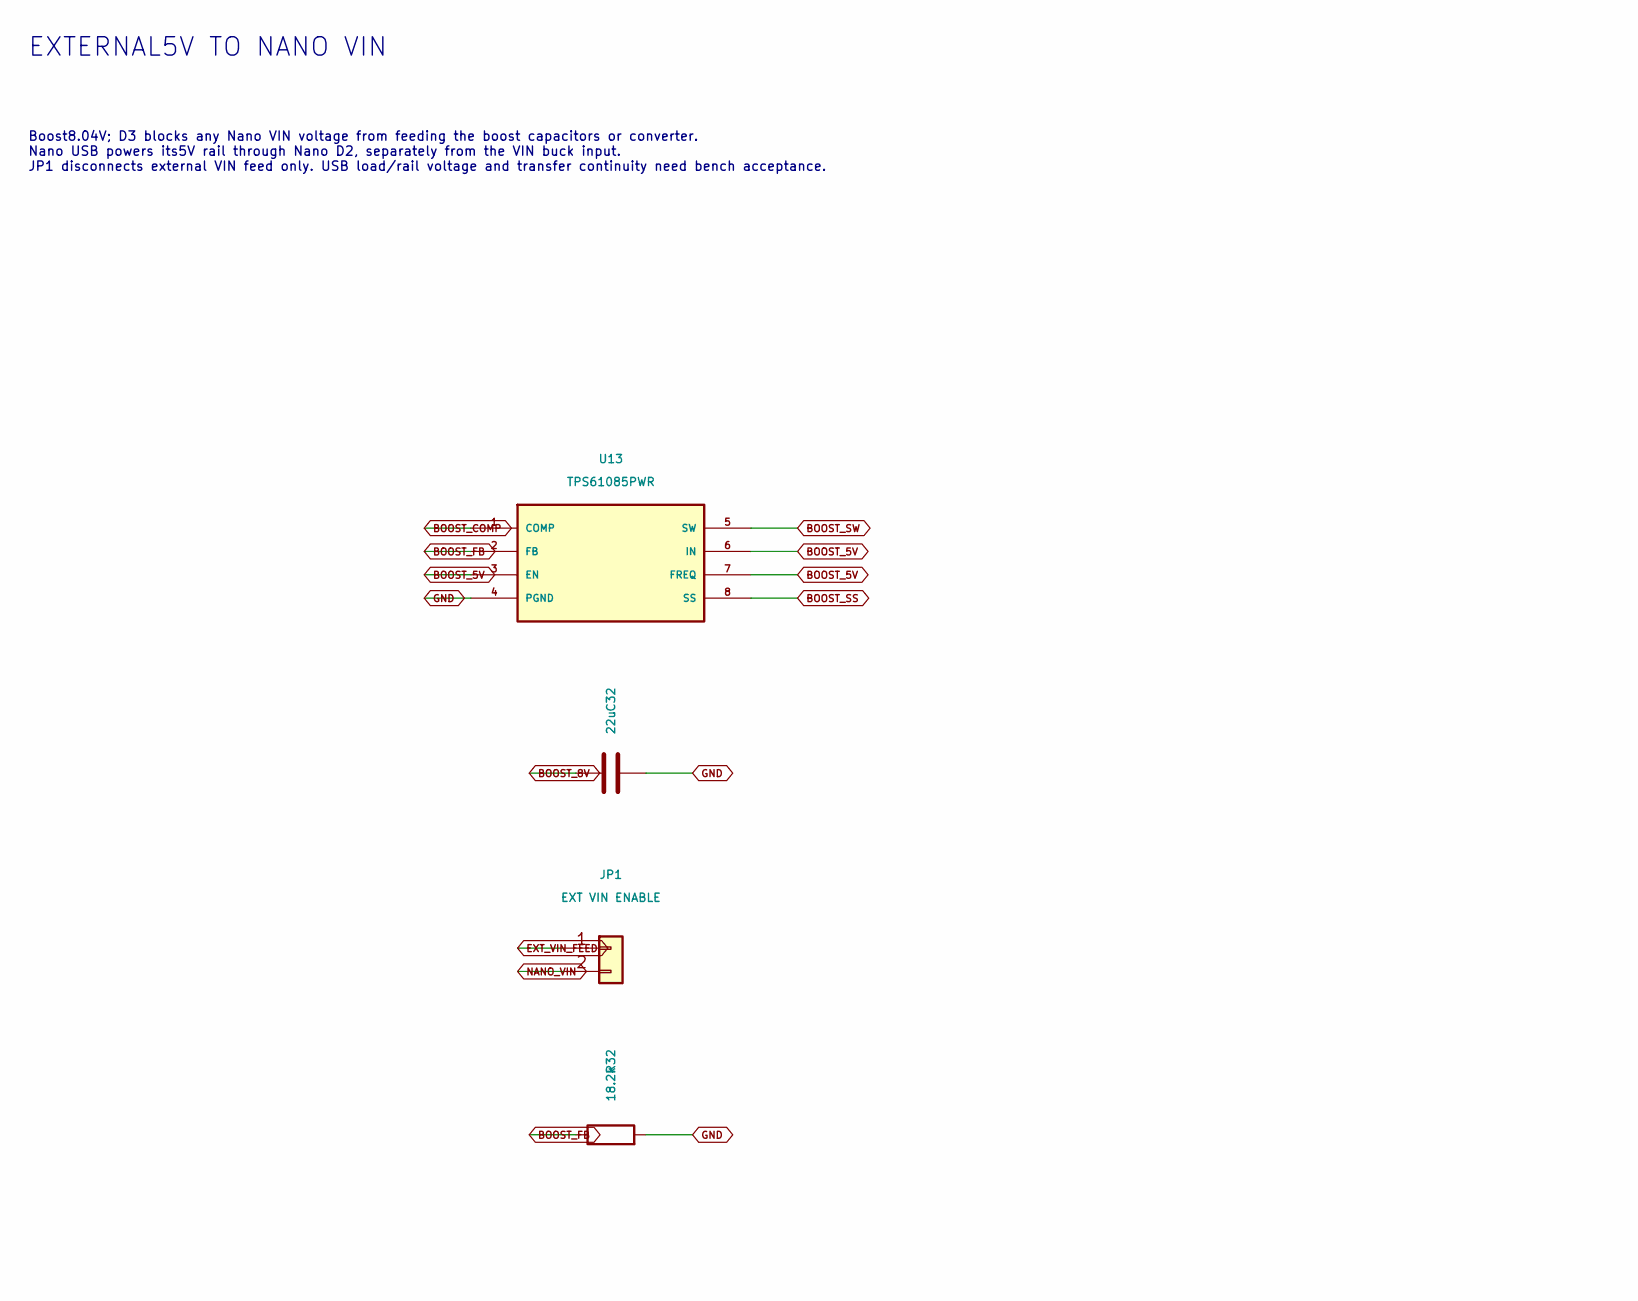
[picture p38: schematic BoostPower.kicad_sch, A.9 | EXTERNAL5V TO NANO VIN, part in row 1, column 1]

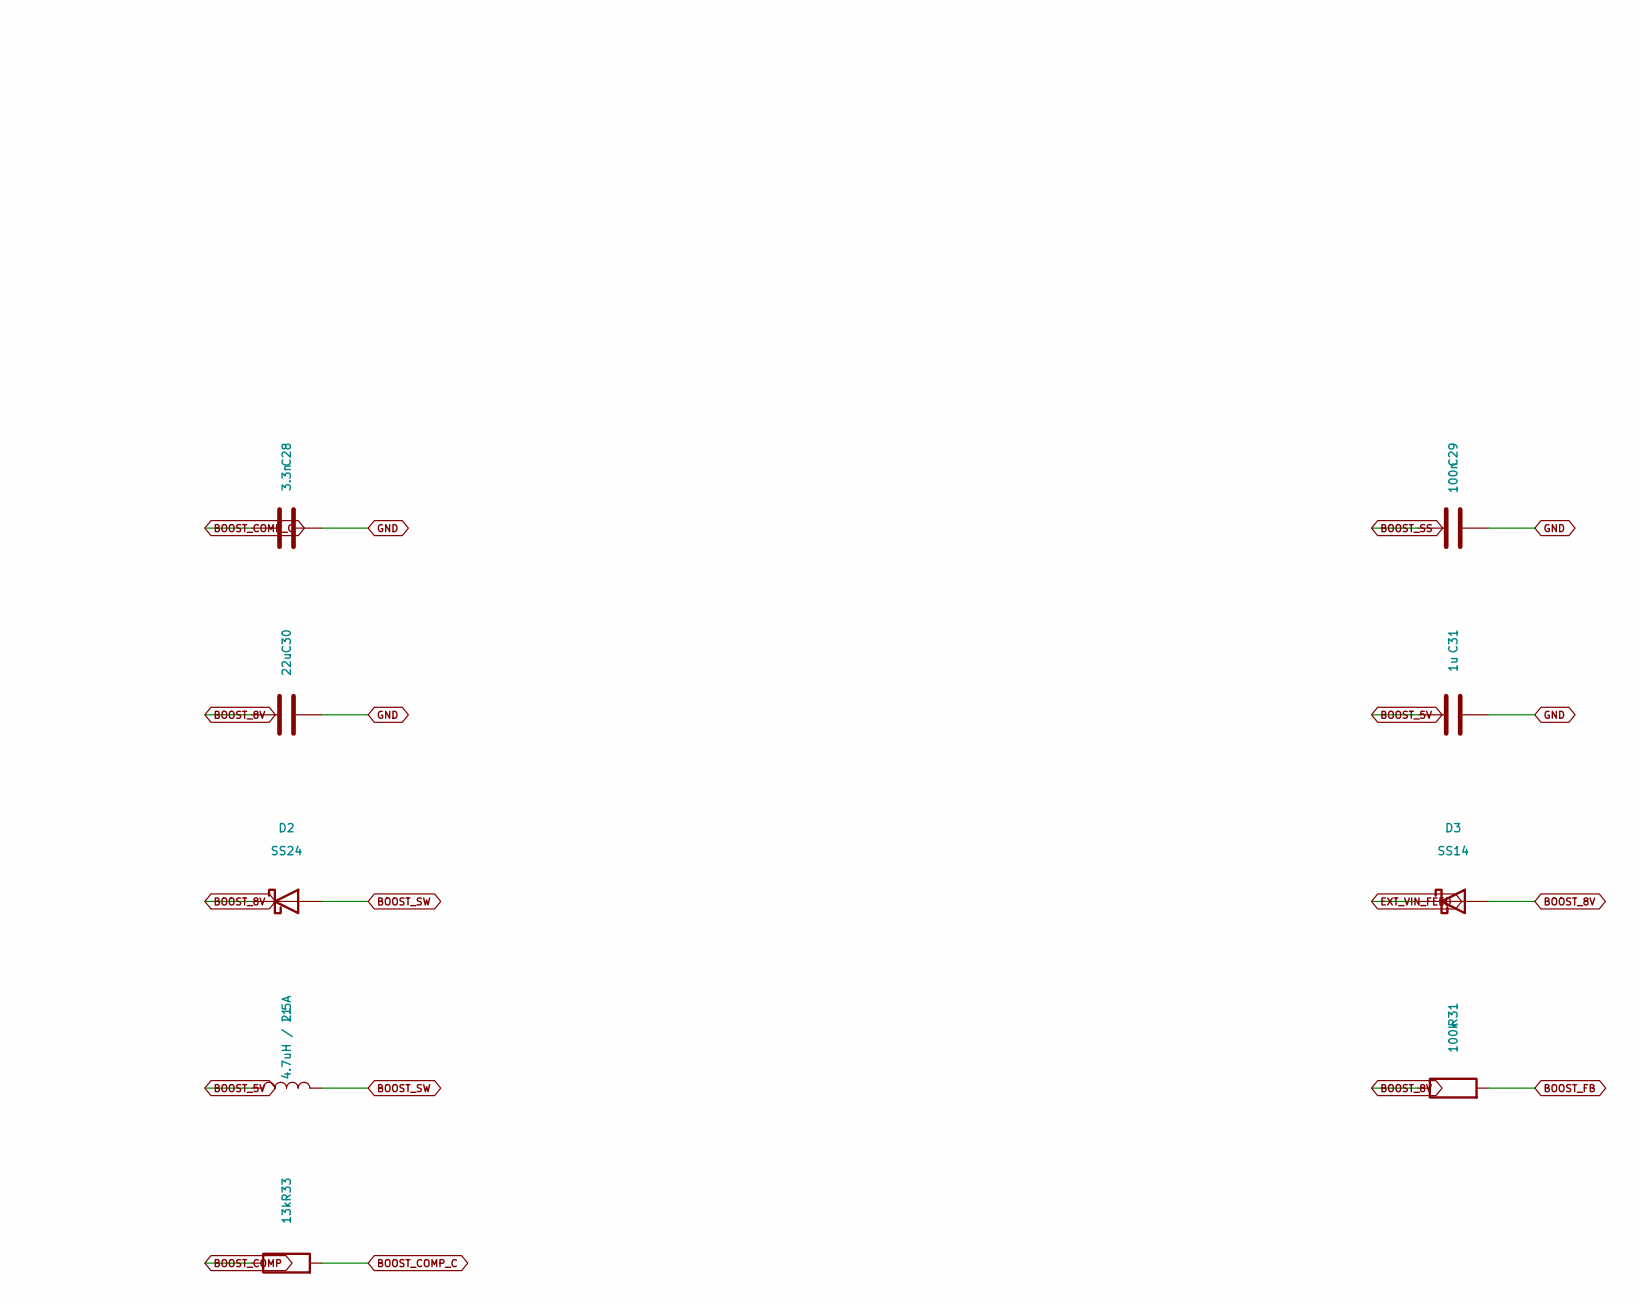
[picture p39: schematic BoostPower.kicad_sch, A.9 | EXTERNAL5V TO NANO VIN, part in row 1, column 2]

Parts:
C28: 3.3n; C_0805_2012Metric; MPN GRM21B5C1H332JA01L
C29: 100n; C_0805_2012Metric; MPN GRM21BR71H104KA01L
C30, C32: 22u; C_1206_3216Metric; MPN GRM31CR71C226KE15L
C31: 1u; C_0805_2012Metric; MPN GRM21BR71C105KA01L
D2: SS24; D_SMA; MPN SS24-E3/61T
D3: SS14; D_SMA; MPN SS14-E3/61T
JP1: EXT VIN ENABLE; PinHeader_1x02_P2.54mm_Vertical; MPN TSW-102-07-G-S
L1: 4.7uH / 2.5A; Wurth_7447785004; MPN 7447785004
R31: 100k; R_0805_2012Metric; MPN RC0805FR-07100KL
R32: 18.2k; R_0805_2012Metric; MPN RC0805FR-0718K2L
R33: 13k; R_0805_2012Metric; MPN RC0805FR-0713KL
U13: TPS61085PWR; TSSOP-8_4.4x3mm_P0.65mm; MPN TPS61085PWR

Connections:
BOOST_5V: C31.1, L1.1, U13.3 (EN), U13.6 (IN), U13.7 (FREQ); also elsewhere on the board
BOOST_8V: C30.1, C32.1, D2.1 (K), D3.2 (A), R31.1
BOOST_COMP: R33.1, U13.1 (COMP)
BOOST_COMP_C: C28.1, R33.2
BOOST_FB: R31.2, R32.1, U13.2 (FB)
BOOST_SS: C29.1, U13.8 (SS)
BOOST_SW: D2.2 (A), L1.2, U13.5 (SW)
EXT_VIN_FEED: D3.1 (K), JP1.1
GND: C28.2, C29.2, C30.2, C31.2, C32.2, R32.2, U13.4 (PGND); also elsewhere on the board
NANO_VIN: JP1.2; also elsewhere on the board

Notes on the sheet:
EXTERNAL5V TO NANO VIN
Boost8.04V; D3 blocks any Nano VIN voltage from feeding the boost capacitors or converter. Nano USB powers its5V rail through Nano D2, separately from the VIN buck input. JP1 disconnects external VIN feed only. USB load/rail voltage and transfer continuity need bench acceptance.

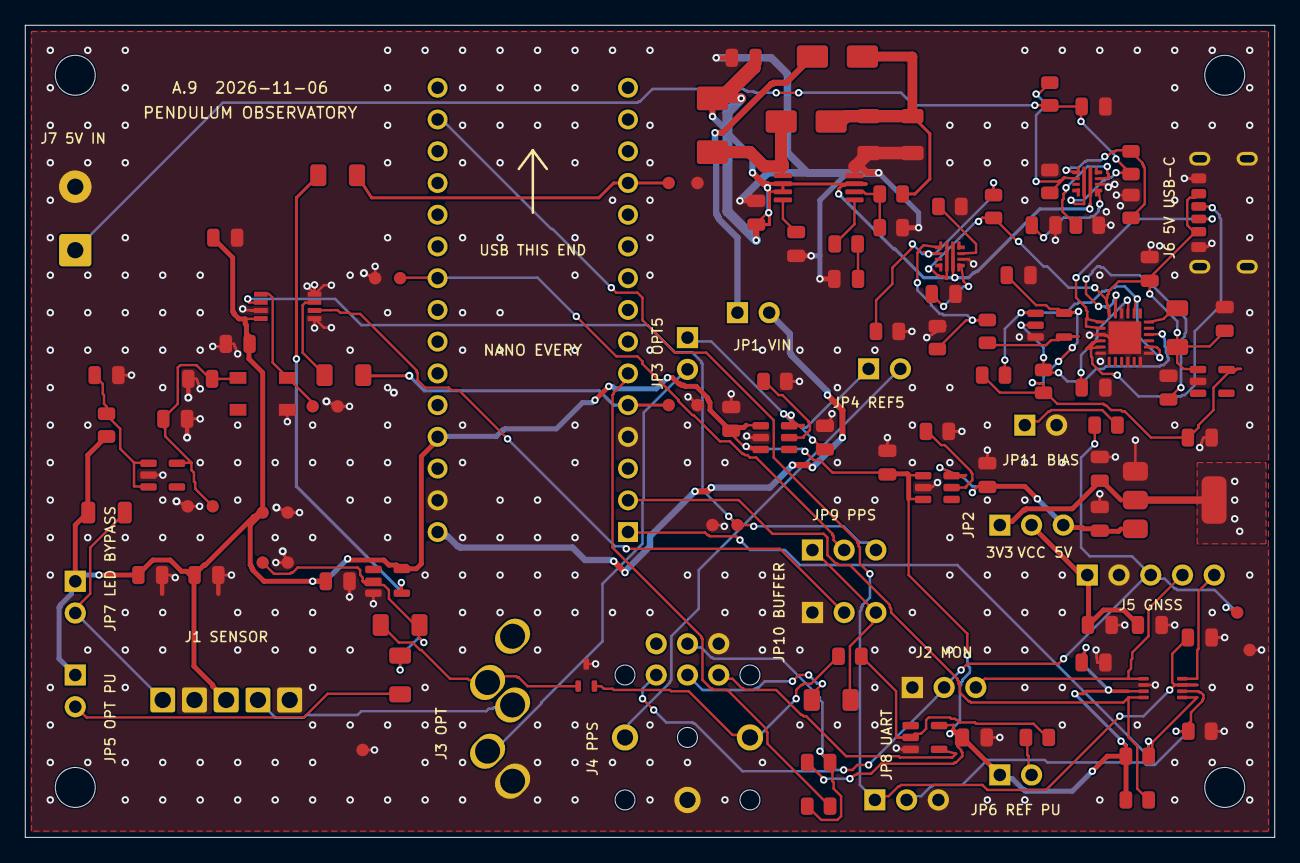
[picture p40: board NanoEveryCarrier.kicad_pcb from above]

Board: 2 copper layers, 100.0 x 65.0 mm, 128 parts (0 on the bottom side), 69 nets.

Other parts of the board:
H1, H2, H3, H4: MountingHole_3.2mm_M3
TP11, TP12, TP13, TP14, TP15, TP16, TP17, TP18, TP19: GND; TestPoint_Pad_D1.0mm

Their connections:
GND: TP11.1, TP12.1, TP13.1, TP14.1, TP15.1, TP16.1, TP17.1, TP18.1, TP19.1; also elsewhere on the board
