flynnr2/Arduino.Nano.Every.TickTock/Nano.Every/Nano.Every.ino

// --------------------------------------------------------------
// Nano Every GPS-Disciplined Pendulum Beat Timer with Tick/Tock Analysis
// Optimized for Arduino Nano Every (ATmega4809) with minimal onboard computation
// Performs capture + PPS disciplining + output packaging on-board; deeper analytics can be offloaded downstream
// --------------------------------------------------------------

// Short-term roadmap items are tracked in Docs/TODO.md.

#include "src/ClockSource.h"
#include "src/PendulumCore.h"
#include "src/PlatformTime.h"

void setup() {
  configureMainClockIfConfigured();
  disableArduinoTimebaseTCB3IfConfigured();
  pendulumSetup();
  digitalWrite(ledPin, HIGH);
  platformDelayMs(5);
  digitalWrite(ledPin, LOW);
}

void loop() {
  pendulumLoop();
}
