flynnr2/Arduino.Nano.Every.TickTock/pendulum_analysis/defaults.yaml

target_period_s: 2.0
phase_mod: 0
clock_profile: generic
analysis_profile: auto
enabled_analyses: []
disabled_analyses: []
force_long_run: false
standard_min_duration_days: 1.0
medium_min_duration_days: 7.0
long_min_duration_days: 21.0
diurnal_min_duration_days: 14.0
weekly_min_duration_days: 21.0
rolling_allan_min_duration_days: 14.0
env_lag_min_duration_days: 14.0
changepoint_min_duration_days: 14.0
diurnal_harmonic_min_duration_days: 14.0
rolling_window_hours: 24.0
rolling_allan_window_hours: 72.0
env_lag_max_hours: 12.0
nominal_hz: 16000000.0
outlier_threshold: 6.0
rolling_window: 101
pps_residual_window: 31
max_points_per_plot: 20000
min_allan_diffs: 20
env_lag_hours: 6
cap16_bins: 256
cap16_min_rows_per_bin: 10
cap16_warn_gap_fraction: 0.02
cap16_fail_gap_fraction: 0.05
cap16_warn_bin_ratio: 2.5
cap16_fail_bin_ratio: 5.0
latency_min_rows: 10
latency_outlier_sigma: 8.0
latency_outlier_median_multiplier: 5.0
fft_expected_periods_s: []
fft_expected_period_labels: []
fft_harmonic_base_periods_s: []
fft_harmonic_max_order: 12
fft_match_tolerance_pct: 1.0
fft_match_tolerance_bin: 1.0
fft_peak_cluster_tolerance_pct: 1.0
disable_profile_fft_expectations: false
fft_top_n: 12
fft_x_axis: period
