flynnr2/Arduino.Nano.Every.TickTock/Raspberry.Pi/pendulum_pi/views.py

"""Scheduled phase analysis and bounded, cached custom-range jobs.

HTTP handlers only request jobs and read published JSON. Heavy computations
run in this service regardless of the number of browsers.
"""
from __future__ import annotations

from contextlib import contextmanager
import fcntl
import hashlib
import json
import math
import os
import re
import sqlite3
import threading
import time

from .common import atomic_json, read_json
from .config import load_settings
from .environmental import EnvironmentalQuery
from .phase import PhaseSnapshots

MAX_JOBS = 8
MAX_CACHE = 32


@contextmanager
def _queue_lock(root):
    with (root / 'queue.lock').open('a') as lock:
        fcntl.flock(lock, fcntl.LOCK_EX)
        yield


def request_environment(settings, start, end, session=None):
    if (any(type(v) not in (int, float) or not math.isfinite(v) for v in (start, end))
            or not 0 <= start < end or end - start > 366 * 86400):
        raise ValueError('Use a finite range up to 366 days with start before end')
    if session is not None and (not isinstance(session, str) or not re.fullmatch(r'[A-Za-z0-9_.:-]{1,128}', session)):
        raise ValueError('Invalid history session')
    # Stable minute cuts let live clients share work instead of generating a new
    # regression for each request. Sub-minute selections retain their exact cut.
    first, last = math.ceil(start / 60) * 60, math.floor(end / 60) * 60
    if first >= last:
        first, last = start, end
    job = dict(start=first, end=last, session=session)
    key = hashlib.sha256(json.dumps(dict(job, algorithm=4), sort_keys=True).encode()).hexdigest()
    root = settings.runtime_dir / 'views'
    root.mkdir(parents=True, exist_ok=True)
    pending = root / (key + '.job.json')
    with _queue_lock(root):
        cached = read_json(root / (key + '.result.json'), {}) or {}
        age = time.time() - cached.get('generated_epoch', float('-inf'))
        jobs = list(root.glob('*.job.json'))
        if not pending.exists() and (not cached or age >= 60):
            if len(jobs) >= MAX_JOBS:
                return dict(cached.get('result') or {'segments': []}, state='busy',
                            message='Analysis queue is busy; this range will retry shortly.')
            atomic_json(pending, job)
        updating = pending.exists()
    result = dict(cached.get('result') or {'segments': []})
    result.update(state='updating' if updating else cached.get('state', 'ready'),
                  requested_start=start, requested_end=end,
                  cache_start=first, cache_end=last,
                  generated_epoch=cached.get('generated_epoch'),
                  message=cached.get('message') or ('Calculating saved environmental relationships.' if updating else None))
    return result


def run_views(settings, config_path, stop=None):
    stop = stop or threading.Event()
    root = settings.runtime_dir / 'views'
    root.mkdir(parents=True, exist_ok=True)
    with (root / 'worker.lock').open('a') as lock:
        try:
            fcntl.flock(lock, fcntl.LOCK_EX | fcntl.LOCK_NB)
        except BlockingIOError:
            raise RuntimeError('another saved-view worker is already running') from None
        phases = PhaseSnapshots()
        previous = read_json(settings.runtime_dir / 'phase.json', {}) or {}
        if isinstance(previous, dict) and previous.get('segment') and previous.get('charts'):
            phases.key = (str(settings.data_dir), previous['segment'])
            phases.result = previous
        last_phase = last_maintenance = float('-inf')
        active = None
        try:
            while not stop.is_set():
                try:
                    settings = load_settings(config_path)
                    if time.monotonic() - last_phase >= 1:
                        phase = phases.get(settings)
                        phase['published_monotonic'] = time.monotonic()
                        atomic_json(settings.runtime_dir / 'phase.json', phase)
                        last_phase = time.monotonic()
                    if active is None:
                        jobs = sorted(root.glob('*.job.json'), key=lambda p: p.stat().st_mtime)
                        if jobs:
                            path = jobs[0]
                            active = (path, None)
                    if active is not None:
                        job_path, job = active
                        value = None
                        try:
                            if job is None:
                                job = EnvironmentalQuery(settings.data_dir, **read_json(job_path, {}))
                                active = (job_path, job)
                            if job.step():
                                value = dict(result=job.result, state='ready', generated_epoch=time.time())
                        except (OSError, ValueError, TypeError, sqlite3.Error) as error:
                            message = ('Environmental calculation took too long. Try a shorter range.'
                                       if isinstance(error, sqlite3.Error)
                                       and getattr(error, 'sqlite_errorcode', None) == sqlite3.SQLITE_INTERRUPT
                                       else str(error))
                            value = dict(result={'segments': []}, state='unavailable',
                                         generated_epoch=time.time(), message=message)
                        if value is not None:
                            # Completion and resubmission share one handoff: a
                            # requester cannot replace a job just before unlink.
                            with _queue_lock(root):
                                atomic_json(root / job_path.name.replace('.job.json', '.result.json'), value)
                                job_path.unlink(missing_ok=True)
                            if job is not None:
                                job.close()
                            active = None
                    if time.monotonic() - last_maintenance >= 1:
                        with _queue_lock(root):
                            cache = sorted(root.glob('*.result.json'), key=lambda p: p.stat().st_mtime, reverse=True)
                            for path in cache[MAX_CACHE:]:
                                path.unlink(missing_ok=True)
                        last_maintenance = time.monotonic()
                    atomic_json(settings.runtime_dir / 'views-health.json',
                                {'state': 'running', 'updated_monotonic': time.monotonic(), 'error': None})
                except (OSError, ValueError, TypeError) as error:
                    atomic_json(settings.runtime_dir / 'views-health.json',
                                {'state': 'error', 'updated_monotonic': time.monotonic(), 'error': str(error)})
                stop.wait(.05 if active is not None else 1)
        finally:
            if active is not None and active[1] is not None:
                active[1].close()
